light655/EENight_light_dance/inverter_v1/inverter_v1_readme.md

# Inverter_v1
This module contains the H-bridge PCB based on the DMHC-3025 chip from Diodes incorporated.
