light655/EENight_light_dance/IC.odt

- Texas Instruments 74HC595 shift register https://www.ti.com/lit/ds/symlink/sn74hc595.pdf
- Texas Instruments TPS25200 eFUSE https://www.ti.com/lit/ds/symlink/tps25200.pdf
- Analog Devices AD5160BRJZ5 digital potentiometer(RDAC) 50kΩ version https://www.analog.com/media/en/technical-documentation/data-sheets/AD5160.pdf
- Richtek RT9187QV low-dropout voltage regulator https://www.lcsc.com/datasheet/lcsc_datasheet_1811150411_Richtek-Tech-RT9187GQV_C147970.pdf
- Texas Instruments 74HC4052 analogue multiplexer https://www.ti.com/lit/ds/symlink/cd74hc4052.pdf
- Texas Instruments TLV9002 operational amplifier https://www.ti.com/lit/ds/symlink/tlv9002.pdf
