light655/EENight_light_dance/array2video/1.png

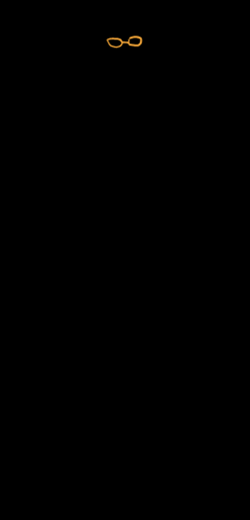
array2video/1.png
