light655/EENight_light_dance/array2video/2.png

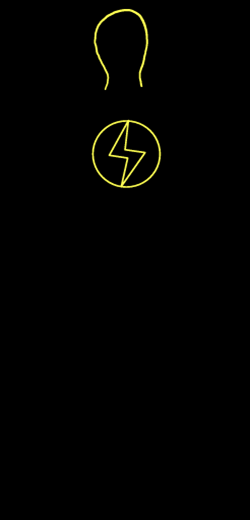
array2video/2.png
