light655/EENight_light_dance/array2video/4.png

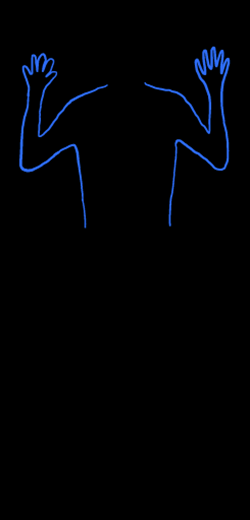
array2video/4.png
