light655/EENight_light_dance/array2video/6.png

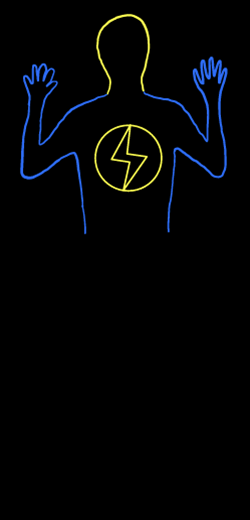
array2video/6.png
