light655/EENight_light_dance/array2video/7.png

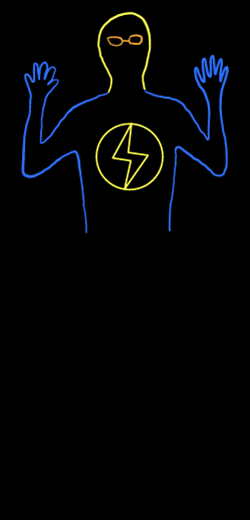
array2video/7.png
