light655/EENight_light_dance/array2video/8.png

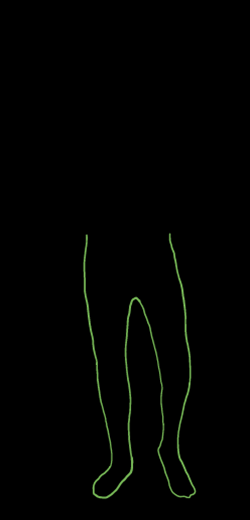
array2video/8.png
