light655/EENight_light_dance/array2video/10.png

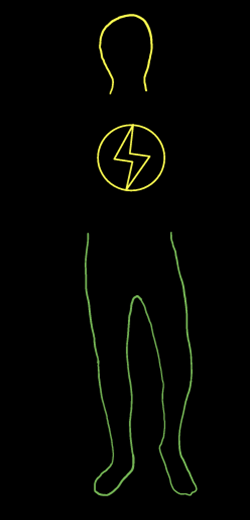
array2video/10.png
