light655/EENight_light_dance/array2video/11.png

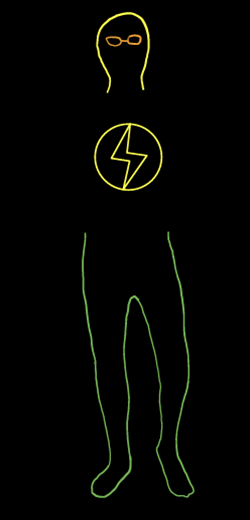
array2video/11.png
