light655/EENight_light_dance/array2video/12.png

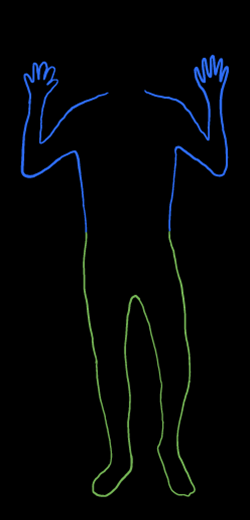
array2video/12.png
