light655/EENight_light_dance/array2video/13.png

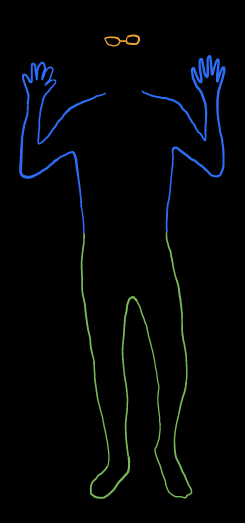
array2video/13.png
