light655/EENight_light_dance/array2video/14.png

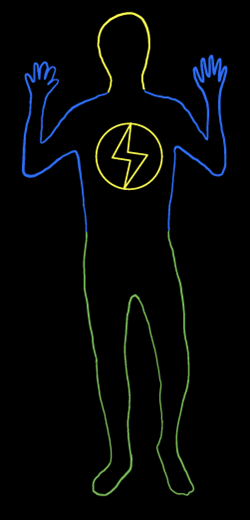
array2video/14.png
