light655/EENight_light_dance/array2video/15.png

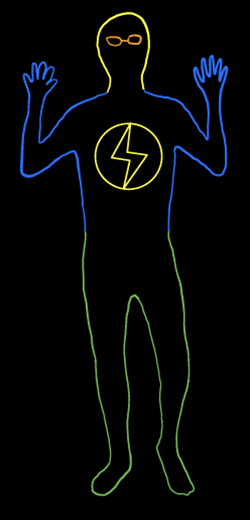
array2video/15.png
