light655/EENight_light_dance/inverter_v1/EL_oscillator/Screenshot from 2024-01-13 21-46-13.png

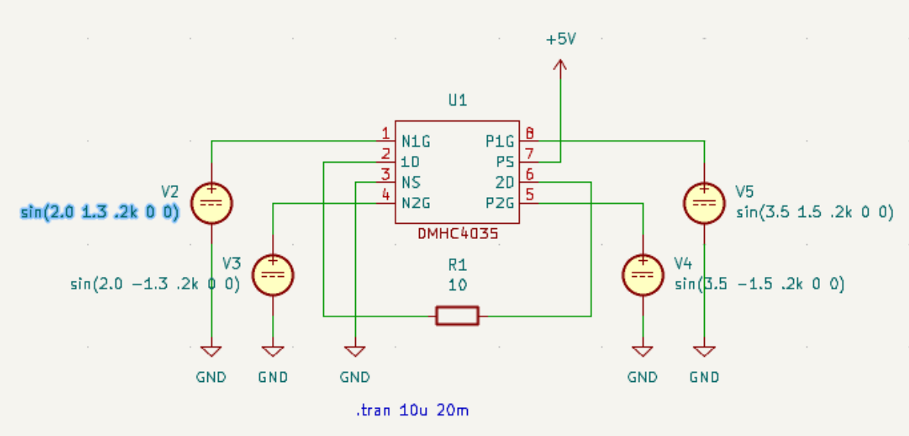
inverter_v1/EL_oscillator/Screenshot from 2024-01-13 21-46-13.png
