light655/EENight_light_dance/driver issues.odt

| Driver #
Machine # | 0 | 1 | 2 | 3
1
2
3 | Max voltage 2.1V | | Max voltage 2.6V
4
5
