light655/EENight_light_dance/pcb.pdf

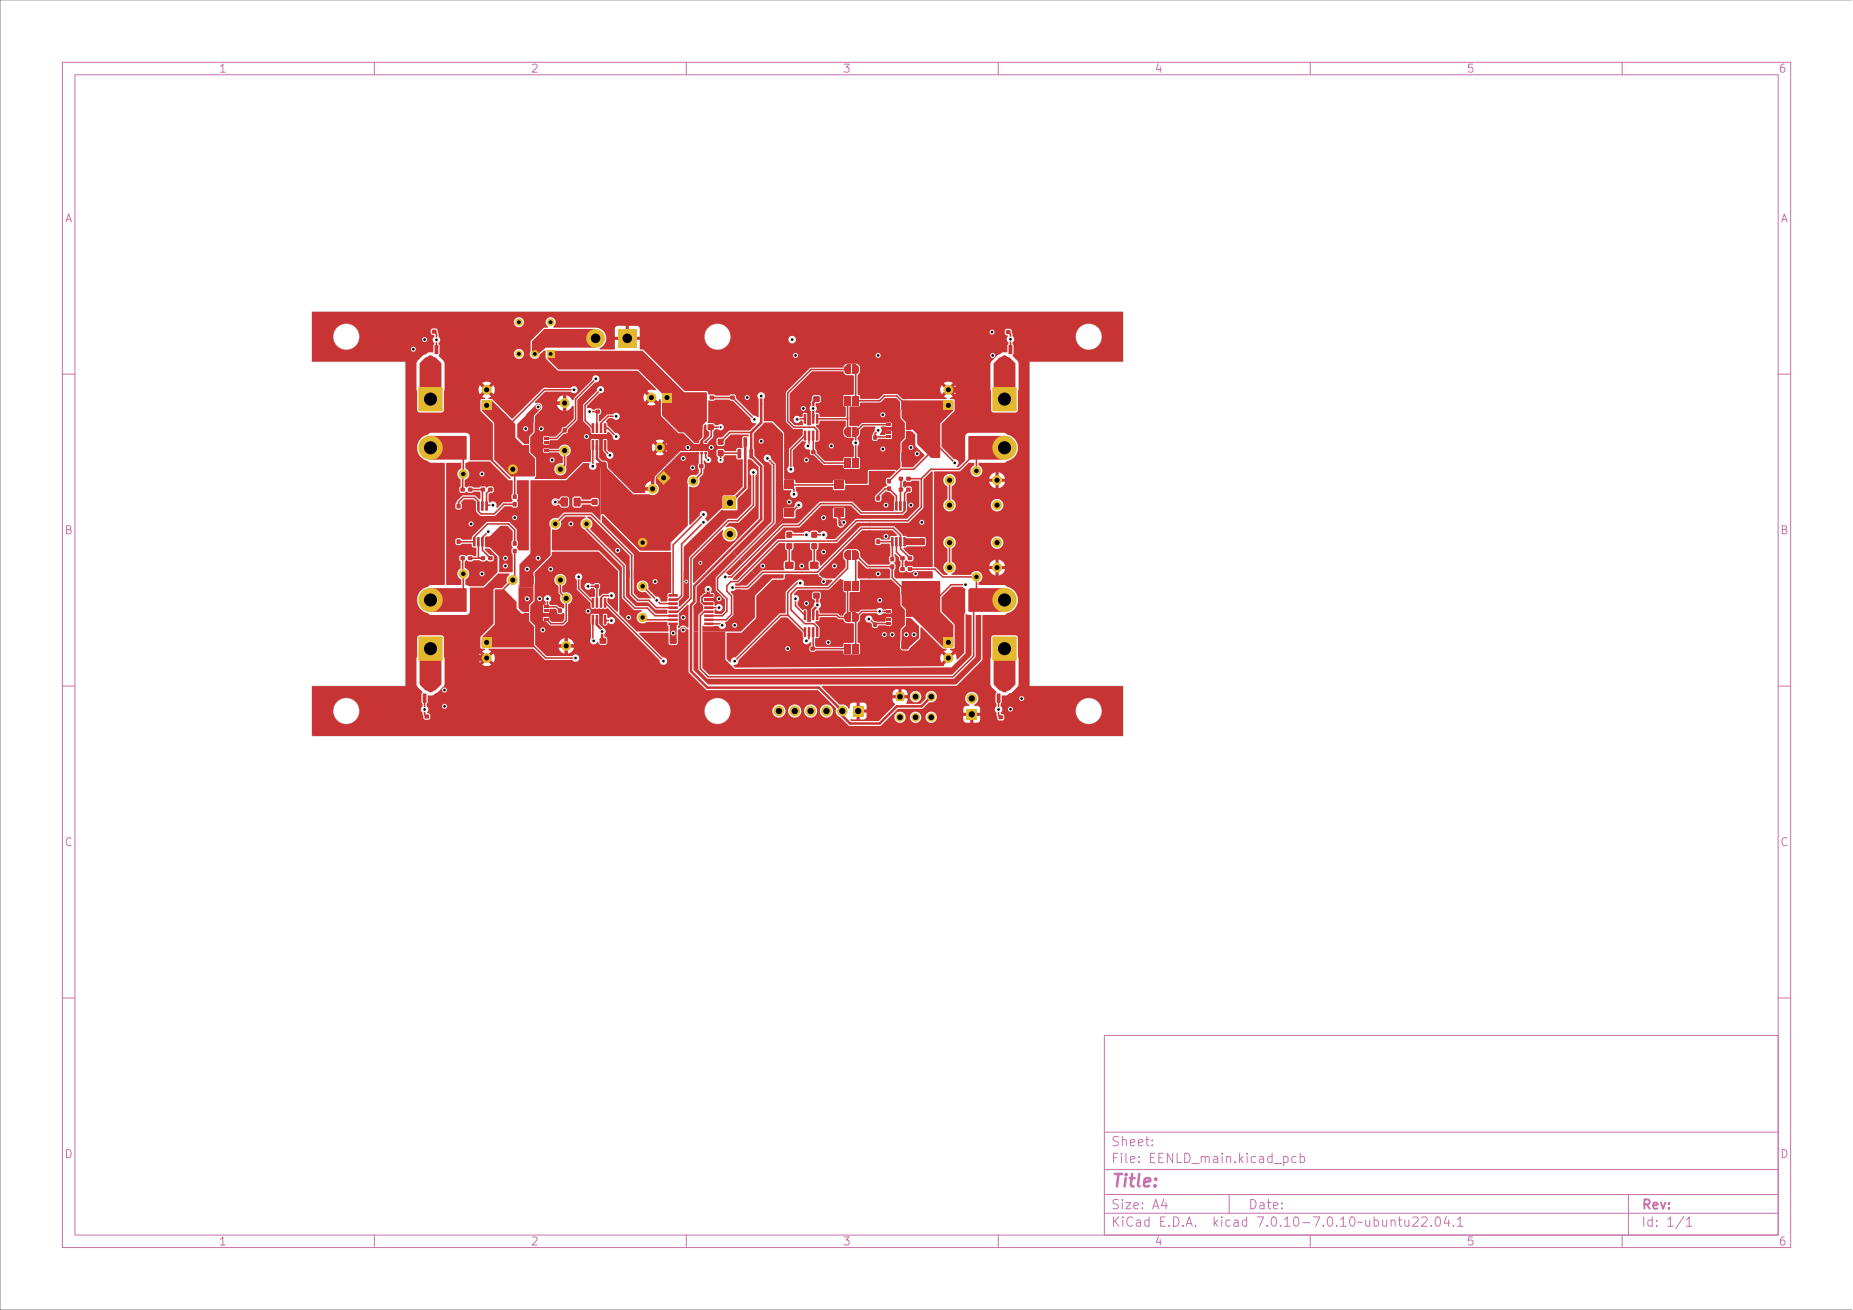
[picture p21: page 1]

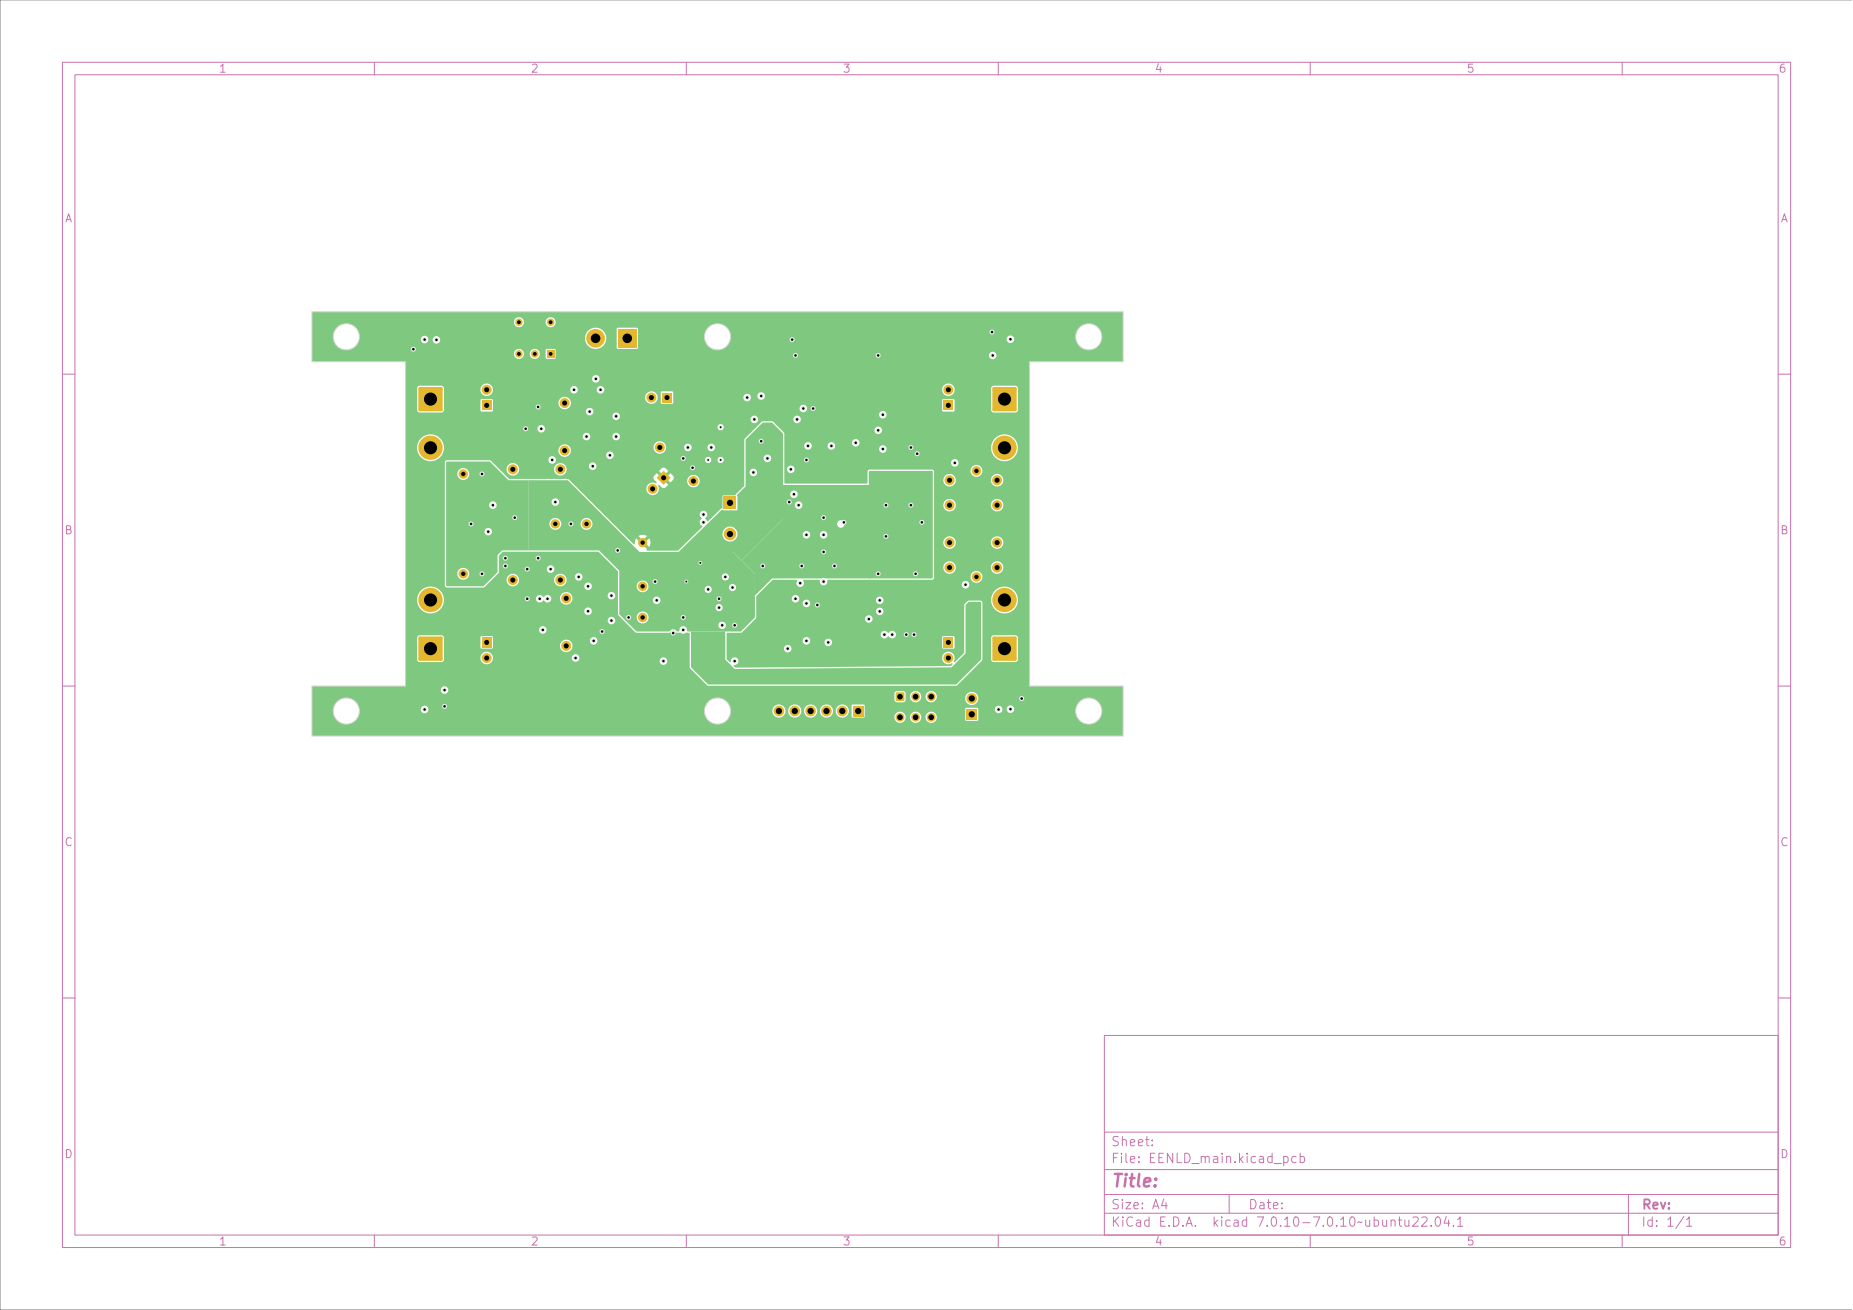
[picture p22: page 2]

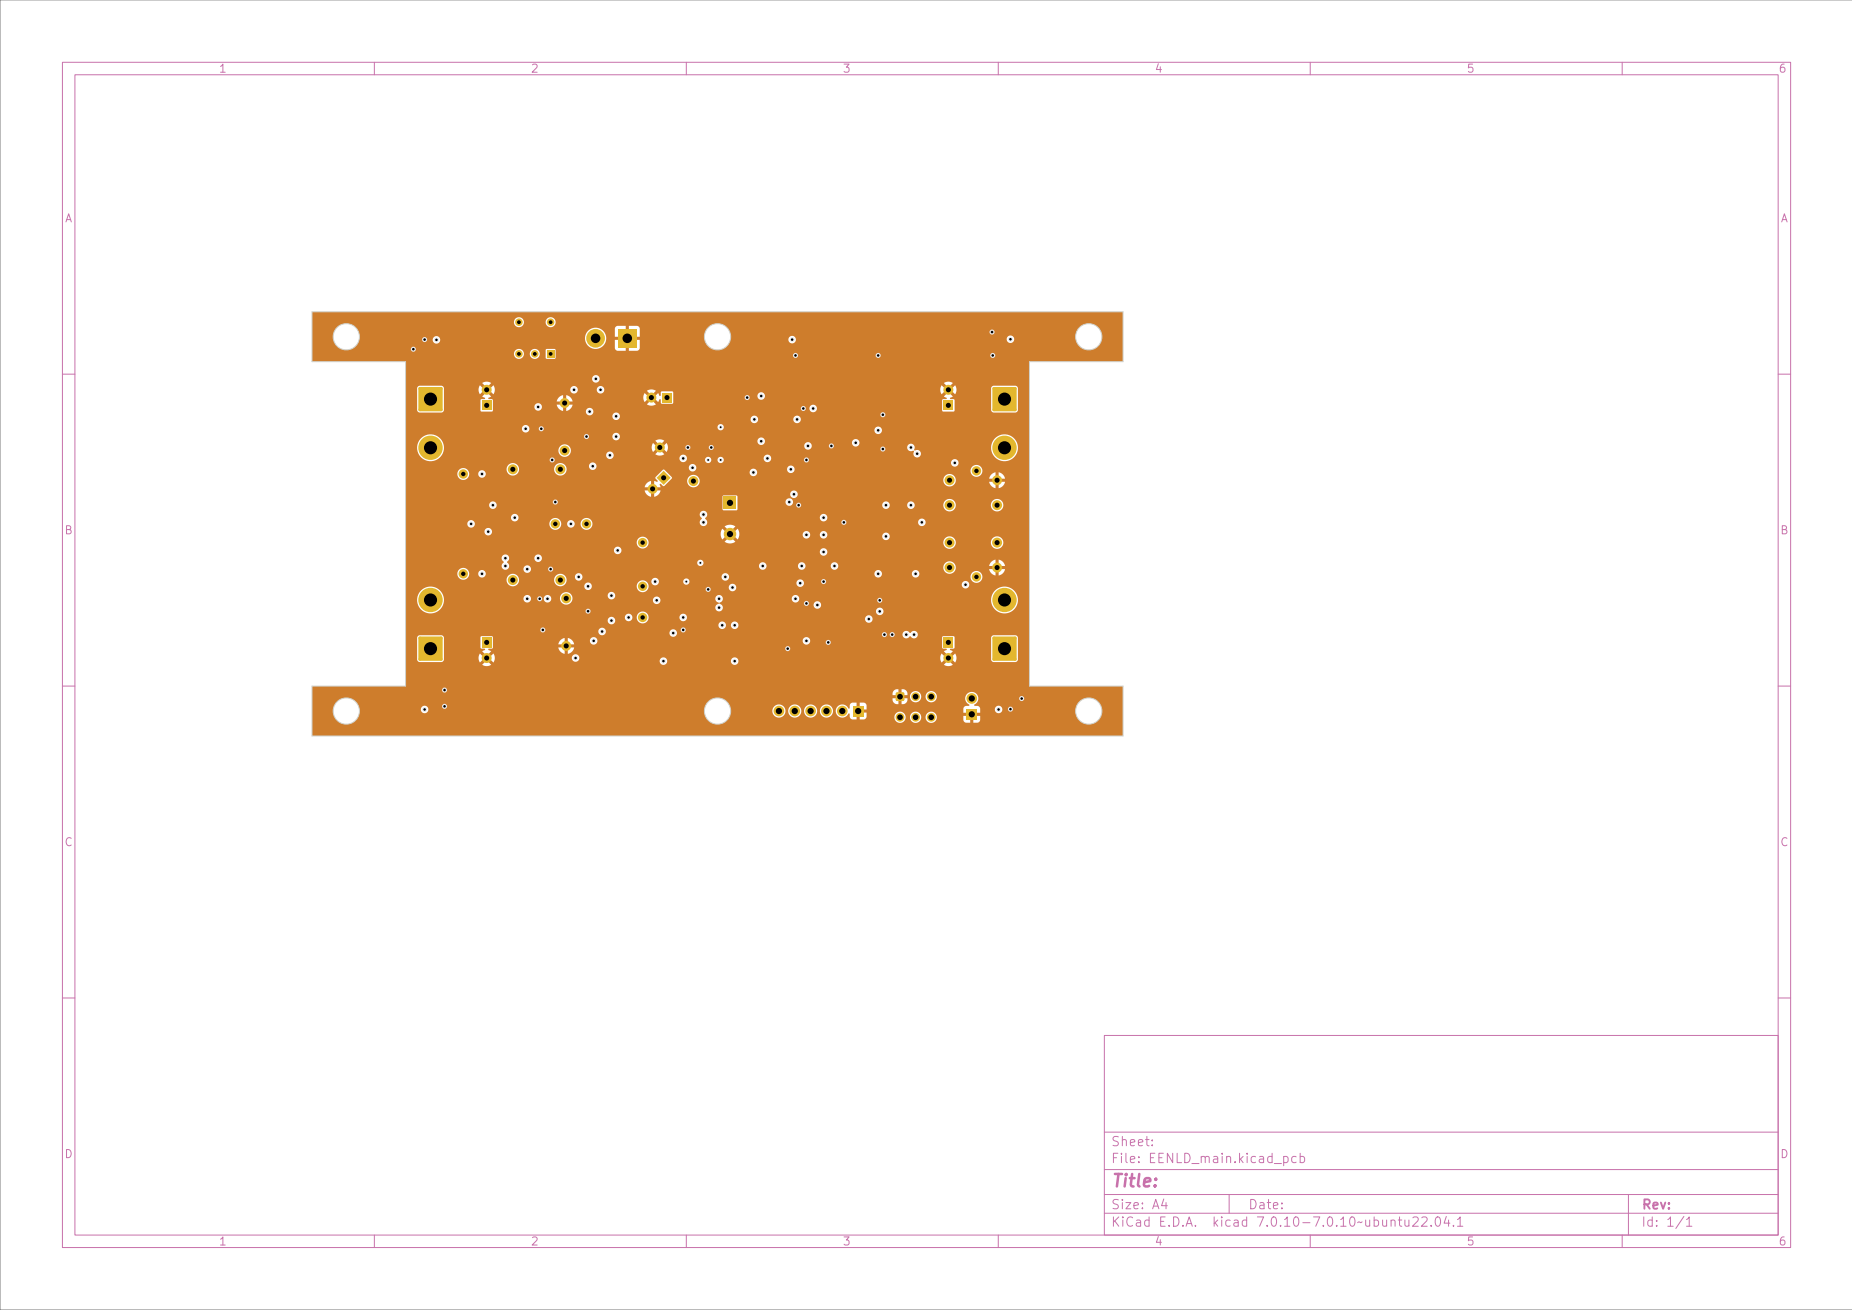
[picture p23: page 3]

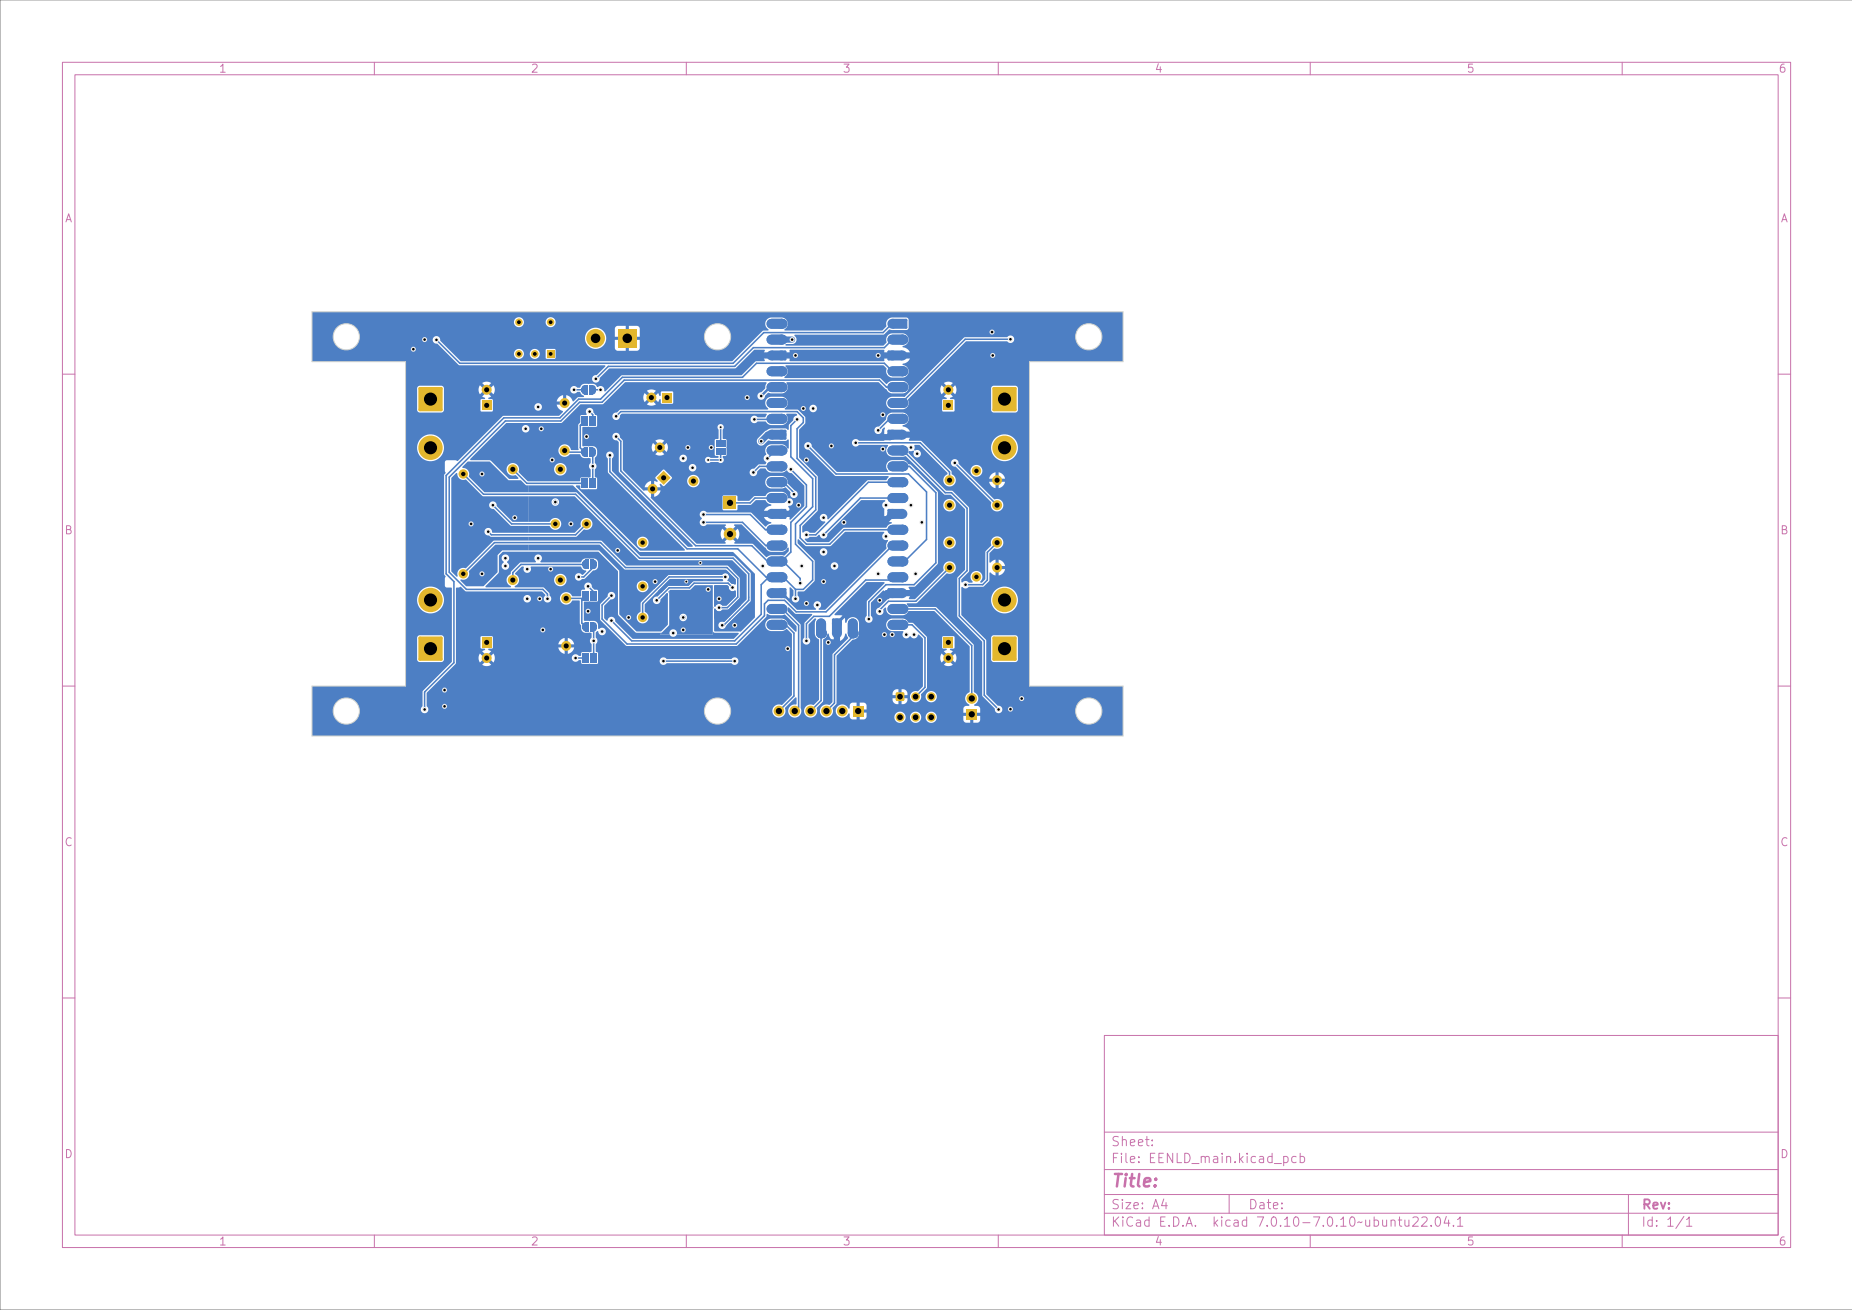
[picture p24: page 4]

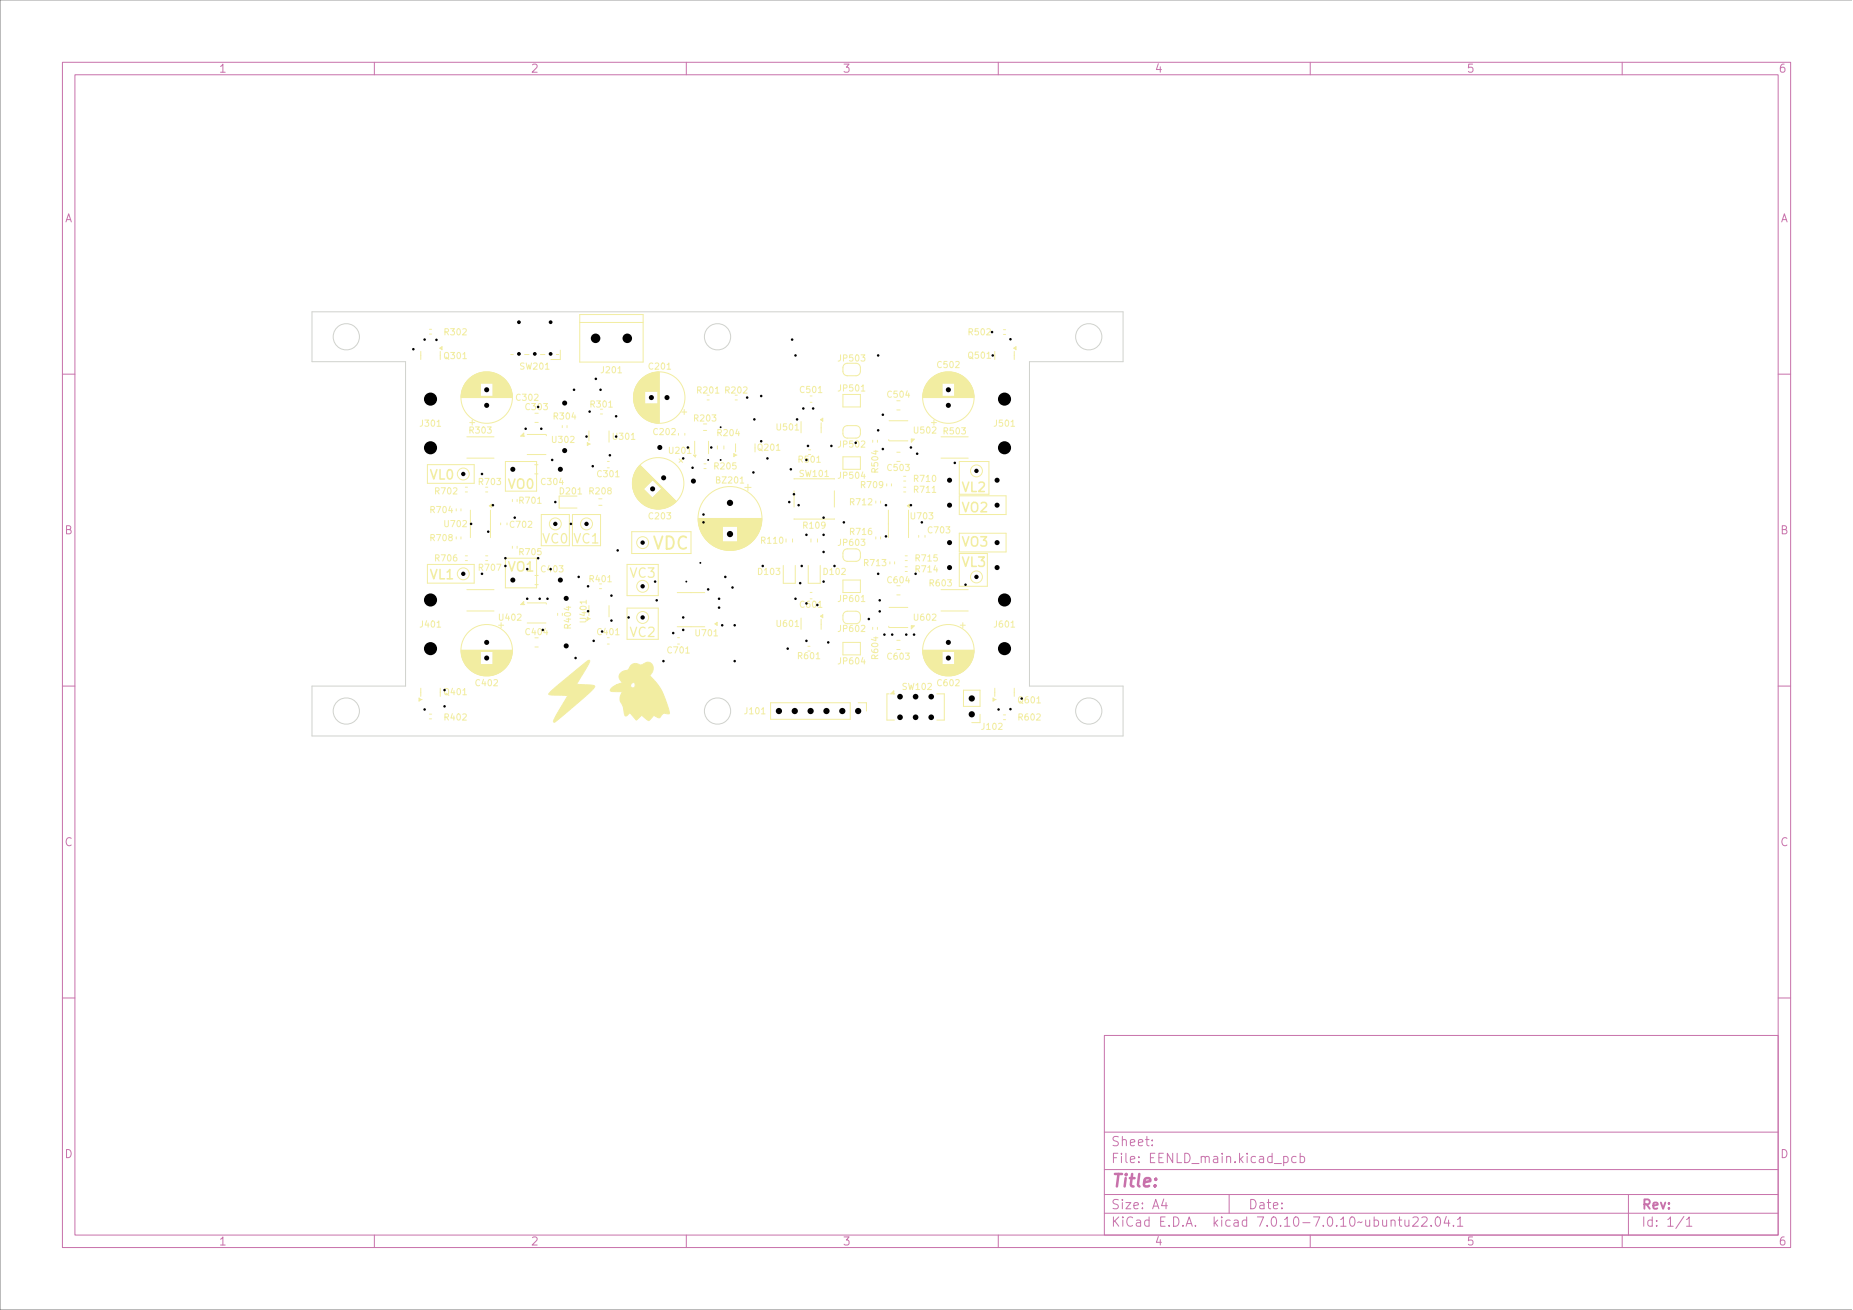
[picture p25: page 5]

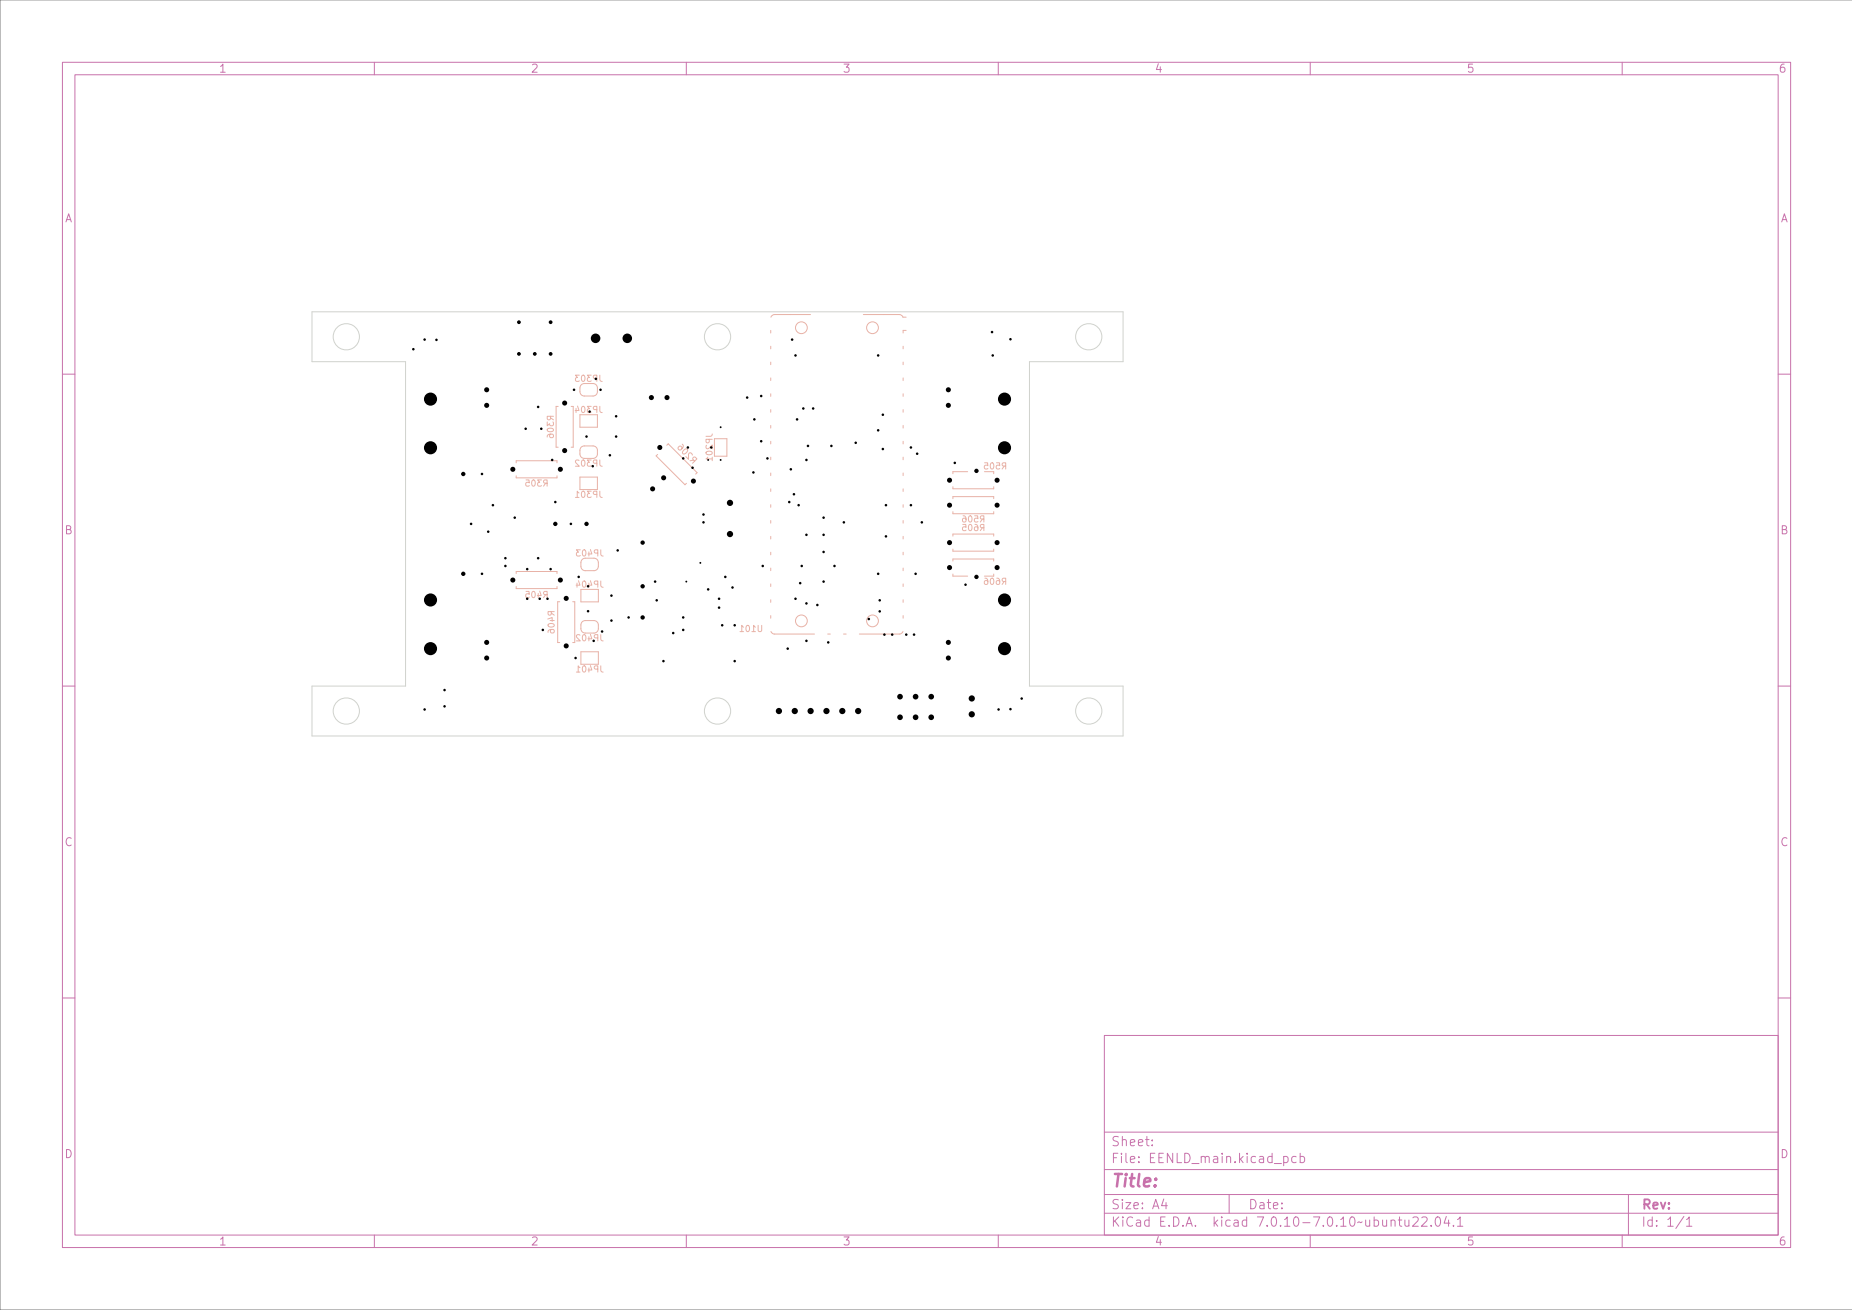
[picture p26: page 6]

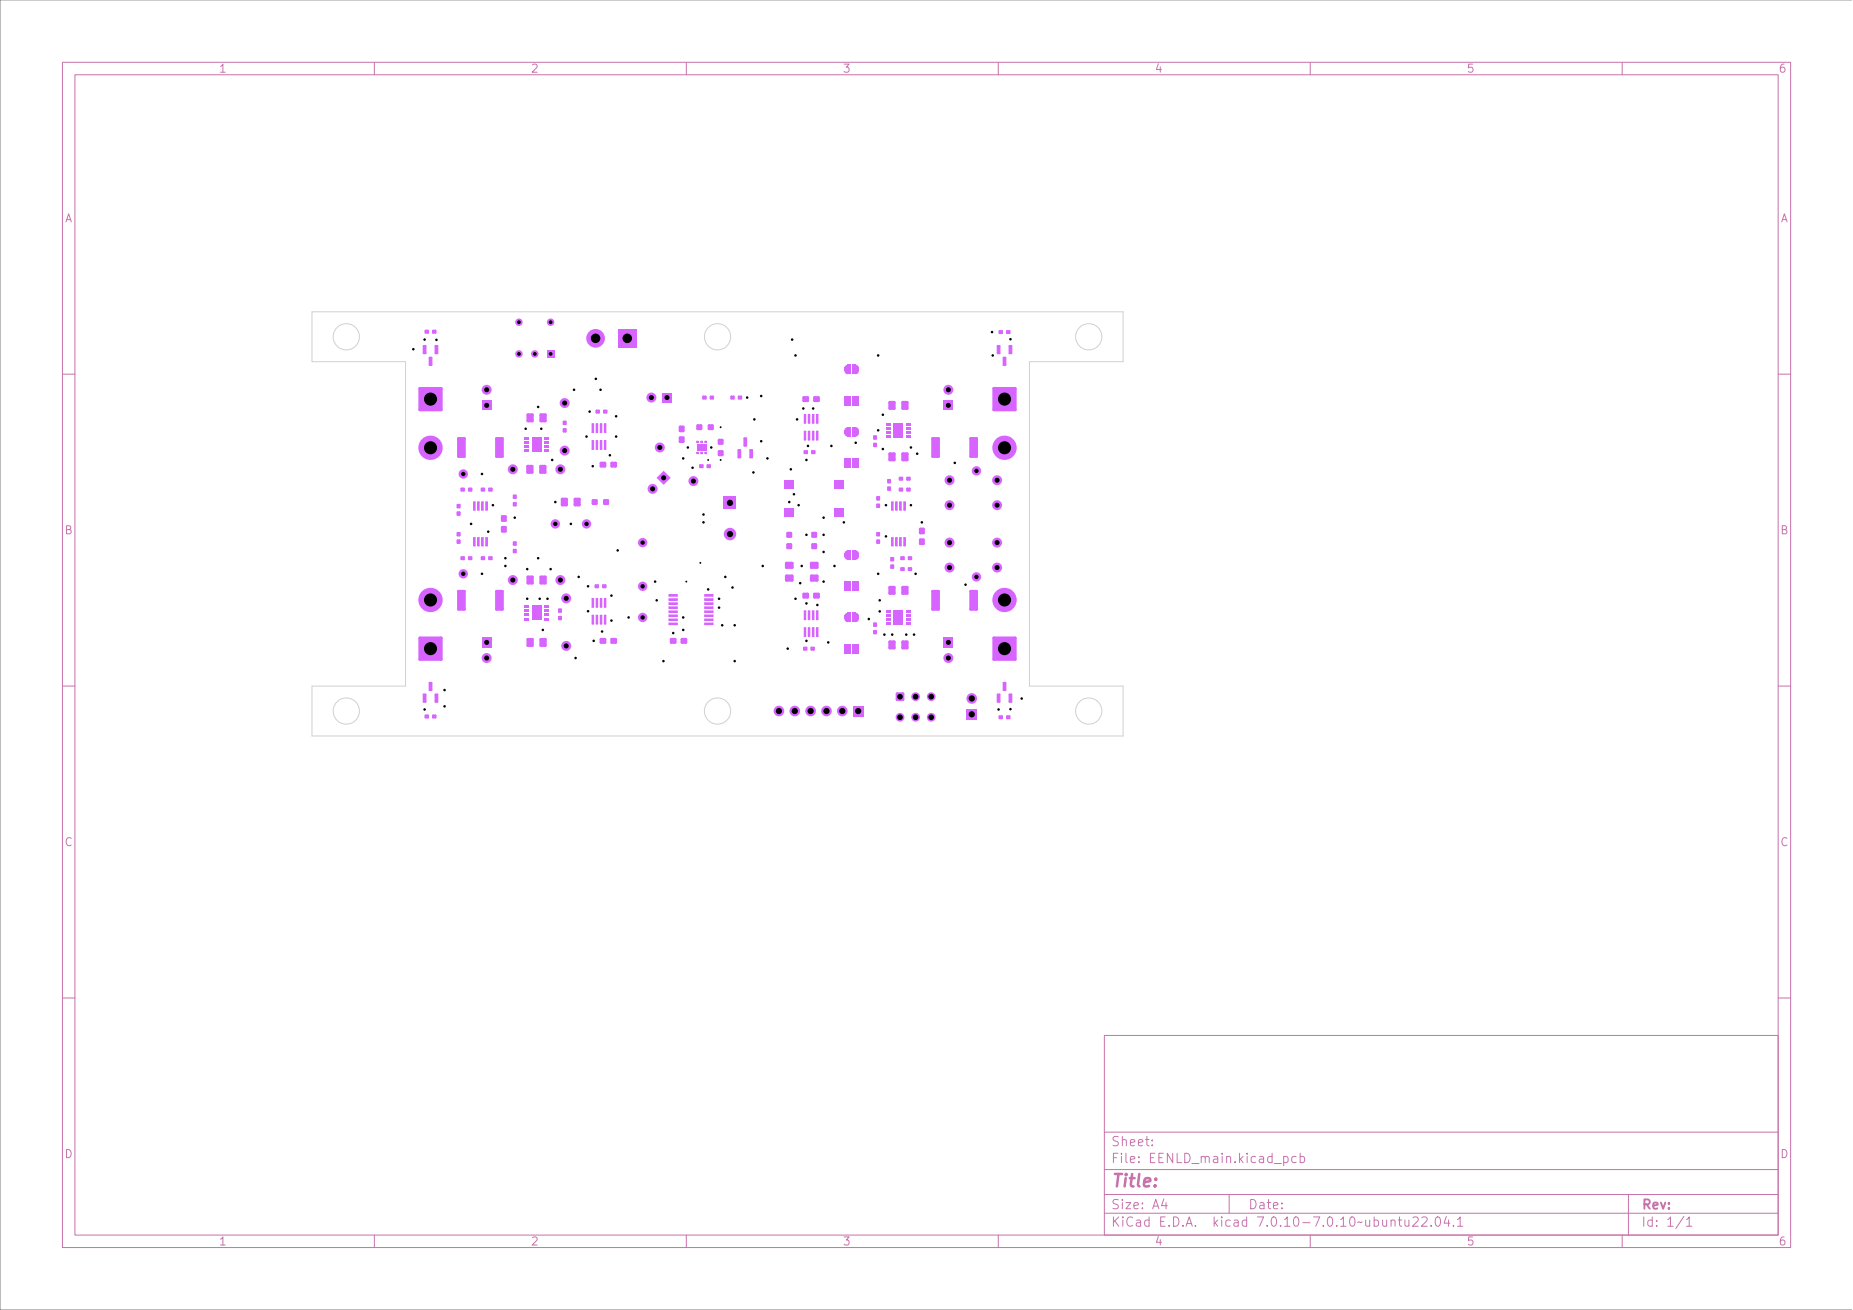
[picture p27: page 7]

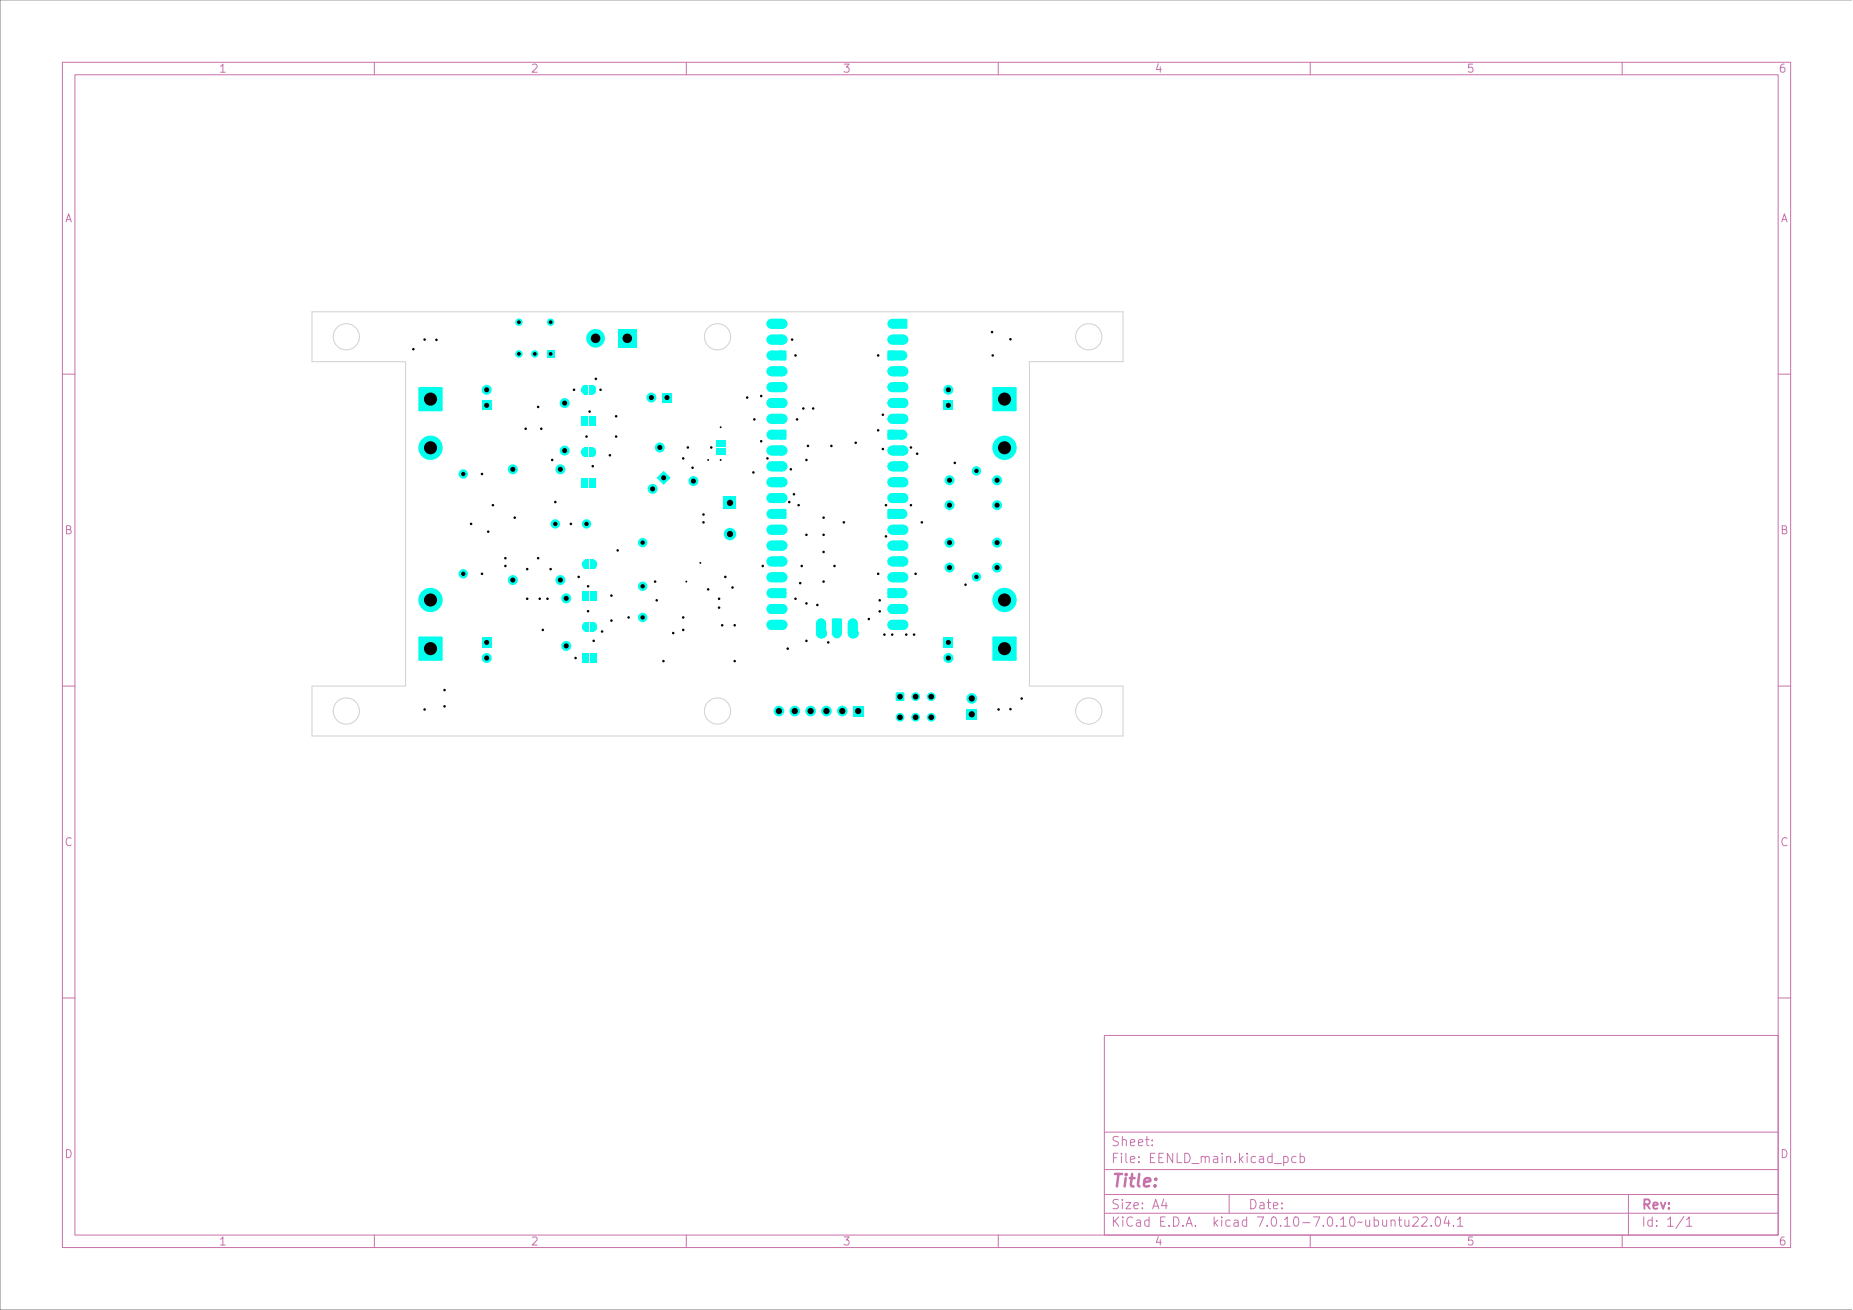
[picture p28: page 8]
