light655/EENight_light_dance/main_board/EENLD_main/EENLD_main.kicad_pcb

## KiCad design main_board/EENLD_main/EENLD_main.kicad_pcb (2024-04-01)

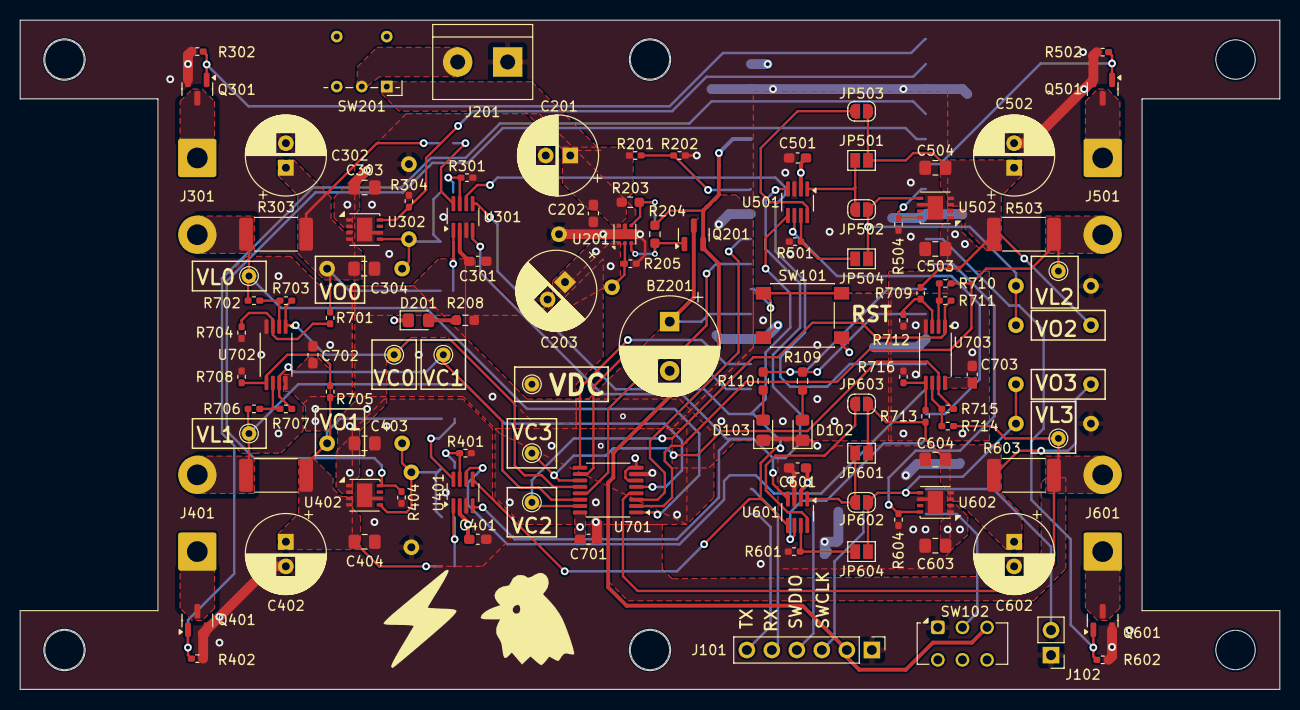
[picture p29: board EENLD_main.kicad_pcb from above]

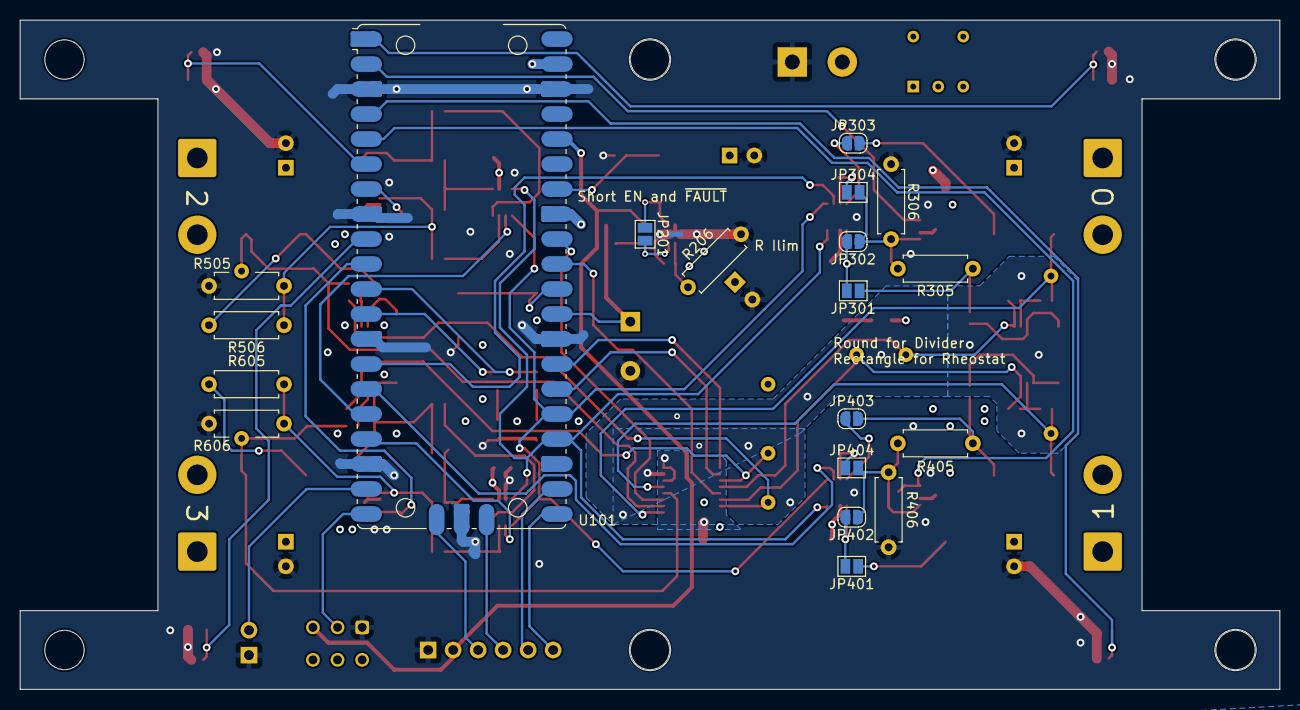
[picture p30: board EENLD_main.kicad_pcb from below]

Board: 4 copper layers, 128.0 x 68.0 mm, 129 parts (19 on the bottom side), 81 nets.

Parts:
BZ201: Buzzer; CP_Radial_D10.0mm_P5.00mm
C201, C203, C302, C402, C502, C602: 100u; CP_Radial_D8.0mm_P2.50mm
C202, C301, C401, C501, C601, C701, C702, C703: 100n; C_0603_1608Metric_Pad1.08x0.95mm_HandSolder
C303, C304, C403, C404, C503, C504, C603, C604: 2.2u; C_0805_2012Metric_Pad1.18x1.45mm_HandSolder
D102: green; LED_0805_2012Metric_Pad1.15x1.40mm_HandSolder
D103: red; LED_0805_2012Metric_Pad1.15x1.40mm_HandSolder
D201: Yellow; LED_0805_2012Metric_Pad1.15x1.40mm_HandSolder
J101: Conn_01x06_Pin; PinHeader_1x06_P2.54mm_Vertical
J102: Conn_01x02_Pin; PinHeader_1x02_P2.54mm_Vertical
J201: Conn_01x02_Socket; TerminalBlock_bornier-2_P5.08mm
J301, J401, J501, J601: Conn_01x02_Socket; SolderWire-1.5sqmm_1x02_P7.8mm_D1.7mm_OD3.9mm
JP201: SolderJumper_2_Open; SolderJumper-2_P1.3mm_Open_Pad1.0x1.5mm
JP301, JP304, JP401, JP404, JP501, JP504, JP601, JP604: Rectangle Jumper Open; SolderJumper-2_P1.3mm_Open_Pad1.0x1.5mm
JP302, JP303, JP402, JP403, JP502, JP503, JP602, JP603: Round Jumper Open; SolderJumper-2_P1.3mm_Open_RoundedPad1.0x1.5mm
Q201: AO3401A; SOT-23
Q301, Q401, Q501, Q601: AO3400A; SOT-23
R109, R110, R208: 1k; R_0603_1608Metric_Pad0.98x0.95mm_HandSolder
R201, R202, R205: 47k; R_0402_1005Metric_Pad0.72x0.64mm_HandSolder
R203, R204: 300k; R_0603_1608Metric_Pad0.98x0.95mm_HandSolder
R206: 47k; R_Axial_DIN0207_L6.3mm_D2.5mm_P7.62mm_Horizontal
R301, R401, R501, R601: 12k; R_0402_1005Metric_Pad0.72x0.64mm_HandSolder
R302, R304, R402, R404, R502, R504, R602, R604, R701, R702, R705, R706, R709, R710, R713, R714: 10k; R_0402_1005Metric_Pad0.72x0.64mm_HandSolder
R303, R403, R503, R603: 200m; R_2512_6332Metric_Pad1.40x3.35mm_HandSolder
R305, R306, R405, R406, R505, R506, R605, R606: 27k; R_Axial_DIN0207_L6.3mm_D2.5mm_P7.62mm_Horizontal
R703, R704, R707, R708, R711, R712, R715, R716: 200k; R_0402_1005Metric_Pad0.72x0.64mm_HandSolder
SW101: SW_Push; SW_Push_1P1T_NO_6x6mm_H9.5mm
SW102: SW_SPDT; SW_CK_JS202011CQN_DPDT_Straight
SW201: SW_SPDT; SW_Lever_1P2T_NKK_GW12LxH
TP201, TP302, TP402, TP502, TP602, TP701, TP702, TP703, TP704: TestPoint; TestPoint_THTPad_D1.5mm_Drill0.7mm
U101: Pico; RaspberryPi_Pico_Original_SMD
U201: TPS25200DRVR; WSON-6-1EP_2x2mm_P0.65mm_EP1x1.6mm_ThermalVias
U301, U401, U501, U601: AD5160BRJZ5; SOT-23-8_Handsoldering
U302, U402, U502, U602: RT9187QV; DFN-8-1EP_3x3mm_P0.65mm_EP1.55x2.4mm
U701: 74HC4052; TSSOP-16_4.4x5mm_P0.65mm
U702, U703: TLV9002; TSSOP-8_4.4x3mm_P0.65mm

Connections:
+3V3: J101.2, Q201.2 (S), R204.1, SW102.3 (C), U101.36 (3V3)
+BATT: C201.1, C202.1, R201.1, R203.1, SW201.1 (A), U201.6 (IN)
/ANALOG_A: U101.31 (GPIO26_ADC0), U701.13 (AN)
/ANALOG_B: U101.32 (GPIO27_ADC1), U701.3 (BN)
/Analogue signal processing/VC0: R703.1, TP701.1, U701.12 (A0), U702.1
/Analogue signal processing/VC1: R707.1, TP702.1, U701.14 (A1), U702.7
/Analogue signal processing/VC2: R711.1, TP703.1, U701.15 (A2), U703.1
/Analogue signal processing/VC3: R715.1, TP704.1, U701.11 (A3), U703.7
/Battery & protection/eFUSE_EN: JP201.1 (A), R203.2, U201.4 (EN)
/Battery & protection/eFUSE_~FAULT: JP201.2 (B), Q201.1 (G), R204.2, U201.3 (*FAULT)
/EL driver 0/LDO_feedback: JP302.1 (A), JP304.2 (B), R305.2, R306.1, U302.5 (ADJ)
/EL driver 1/LDO_feedback: JP402.1 (A), JP404.2 (B), R405.2, R406.1, U402.5 (ADJ)
/EL driver 2/LDO_feedback: JP502.1 (A), JP504.2 (B), R505.2, R506.1, U502.5 (ADJ)
/EL driver 3/LDO_feedback: JP602.1 (A), JP604.2 (B), R605.2, R606.1, U602.5 (ADJ)
/LDO_EN0: R304.1, U101.2 (GPIO1), U302.8 (EN)
/LDO_EN1: R404.1, U101.5 (GPIO3), U402.8 (EN)
/LDO_EN2: R504.1, U101.7 (GPIO5), U502.8 (EN)
/LDO_EN3: R604.1, U101.10 (GPIO7), U602.8 (EN)
/MUX_S0: U101.26 (GPIO20), U701.10 (S0)
/MUX_S1: U101.27 (GPIO21), U701.9 (S1)
/PWM0: Q301.1 (G), R302.1, U101.1 (GPIO0)
/PWM1: Q401.1 (G), R402.1, U101.4 (GPIO2)
/PWM2: Q501.1 (G), R502.1, U101.6 (GPIO4)
/PWM3: Q601.1 (G), R602.1, U101.9 (GPIO6)
/SPI_CLK: U101.24 (GPIO18), U301.4 (CLK), U401.4 (CLK), U501.4 (CLK), U601.4 (CLK)
/SPI_TX: U101.25 (GPIO19), U301.5 (SDI), U401.5 (SDI), U501.5 (SDI), U601.5 (SDI)
/SPI_~CS0: U101.14 (GPIO10), U301.6 (~CS)
/SPI_~CS1: U101.15 (GPIO11), U401.6 (~CS)
/SPI_~CS2: U101.16 (GPIO12), U501.6 (~CS)
/SPI_~CS3: U101.17 (GPIO13), U601.6 (~CS)
/SSD_CLK: R110.1, U101.11 (GPIO8)
/SSD_DATA: R109.1, U101.12 (GPIO9)
/SWCLK: J101.3, U101.41 (SWCLK)
/SWDIO: J101.4, U101.43 (SWDIO)
/T_SYNC: J102.2, U101.19 (GPIO14)
/UART0_RX: J101.5, U101.22 (GPIO17)
/UART0_TX: J101.6, U101.21 (GPIO16)
/VBAT_sense: R201.2, R202.1, U101.34 (GPIO28_ADC2)
/VL0: J301.2, R303.2, R702.1, TP302.1, U701.1 (B0)
/VL1: J401.2, R403.2, R706.1, TP402.1, U701.5 (B1)
/VL2: J501.2, R503.2, R710.1, TP502.1, U701.2 (B2)
/VL3: J601.2, R603.2, R714.1, TP602.1, U701.4 (B3)
/VO0: C302.1, C304.1, JP301.1 (A), JP303.2 (B), R303.1, R305.1, R701.1, U302.3 (VOUT), U302.4 (VOUT)
/VO1: C402.1, C404.1, JP401.1 (A), JP403.2 (B), R403.1, R405.1, R705.1, U402.3 (VOUT), U402.4 (VOUT)
/VO2: C502.1, C504.1, JP501.1 (A), JP503.2 (B), R503.1, R505.1, R709.1, U502.3 (VOUT), U502.4 (VOUT)
/VO3: C602.1, C604.1, JP601.1 (A), JP603.2 (B), R603.1, R605.1, R713.1, U602.3 (VOUT), U602.4 (VOUT)
/eFUSE_FAULT: BZ201.1 (+), Q201.3 (D), U101.29 (GPIO22)
GND: BZ201.2 (-), C201.2, C202.2, C203.2, C301.2, C302.2, C303.2, C304.2, C401.2, C402.2, C403.2, C404.2, C501.2, C502.2, C503.2, C504.2, C601.2, C602.2, C603.2, C604.2, C701.2, D102.1 (K), D103.1 (K), D201.1 (K), J101.1, J102.1, J201.1, Q301.2 (S), Q401.2 (S), Q501.2 (S), Q601.2 (S), R202.2, R205.2, R206.2, R301.2, R302.2, R304.2, R306.2, R401.2, R402.2, R404.2, R406.2, R501.2, R502.2, R504.2, R506.2, R601.2, R602.2, R604.2, R606.2, SW101.2, SW102.1 (A), U101.3 (GND), U101.8 (GND), U101.13 (GND), U101.18 (GND), U101.23 (GND), U101.28 (GND), U101.38 (GND), U101.42 (GND), U201.5 (GND), U201.7 (EPAD), U301.3 (GND), U302.6 (GND), U302.9 (GND), U401.3 (GND), U402.6 (GND), U402.9 (GND), U501.3 (GND), U502.6 (GND), U502.9 (GND), U601.3 (GND), U602.6 (GND), U602.9 (GND), U701.6 (~E), U701.8 (GND)
GNDA: C702.2, C703.2, R704.2, R708.2, R712.2, R716.2, U101.33 (AGND), U701.7 (VEE), U702.4 (V-), U703.4 (V-)
unnamed: D102.2 (A), R109.2
unnamed: D103.2 (A), R110.2
unnamed: D201.2 (A), R208.2
unnamed: J201.2, SW201.2 (B)
unnamed: J301.1, Q301.3 (D)
unnamed: J401.1, Q401.3 (D)
unnamed: J501.1, Q501.3 (D)
unnamed: J601.1, Q601.3 (D)
unnamed: JP301.2 (B), JP302.2 (B), U301.1 (W)
unnamed: JP303.1 (A), U301.8 (A)
unnamed: JP304.1 (A), R301.1, U301.7 (B)
unnamed: JP401.2 (B), JP402.2 (B), U401.1 (W)
unnamed: JP403.1 (A), U401.8 (A)
unnamed: JP404.1 (A), R401.1, U401.7 (B)
unnamed: JP501.2 (B), JP502.2 (B), U501.1 (W)
unnamed: JP503.1 (A), U501.8 (A)
unnamed: JP504.1 (A), R501.1, U501.7 (B)
unnamed: JP601.2 (B), JP602.2 (B), U601.1 (W)
unnamed: JP603.1 (A), U601.8 (A)
unnamed: JP604.1 (A), R601.1, U601.7 (B)
unnamed: SW102.2 (B), U101.20 (GPIO15)
unnamed: SW101.1, U101.30 (RUN)
unnamed: R205.1, R206.1, U201.2 (ILIM)
unnamed: R701.2, R704.1, U702.3 (+)
unnamed: R702.2, R703.2, U702.2 (-)
unnamed: R705.2, R708.1, U702.5 (+)
unnamed: R706.2, R707.2, U702.6 (-)
unnamed: R709.2, R712.1, U703.3 (+)
unnamed: R710.2, R711.2, U703.2 (-)
unnamed: R713.2, R716.1, U703.5 (+)
unnamed: R714.2, R715.2, U703.6 (-)
VDC: C203.1, C301.1, C303.1, C401.1, C403.1, C501.1, C503.1, C601.1, C603.1, C701.1, C702.1, C703.1, R208.1, TP201.1, U101.39 (VSYS), U201.1 (OUT), U301.2 (VDD), U302.1 (VIN), U302.2 (VIN), U401.2 (VDD), U402.1 (VIN), U402.2 (VIN), U501.2 (VDD), U502.1 (VIN), U502.2 (VIN), U601.2 (VDD), U602.1 (VIN), U602.2 (VIN), U701.16 (VDD), U702.8 (V+), U703.8 (V+)
