light655/EENight_light_dance/BMS/BMS_hardware/BMS_hardware.kicad_pcb

## KiCad design BMS/BMS_hardware/BMS_hardware.kicad_pcb (2024-03-17)

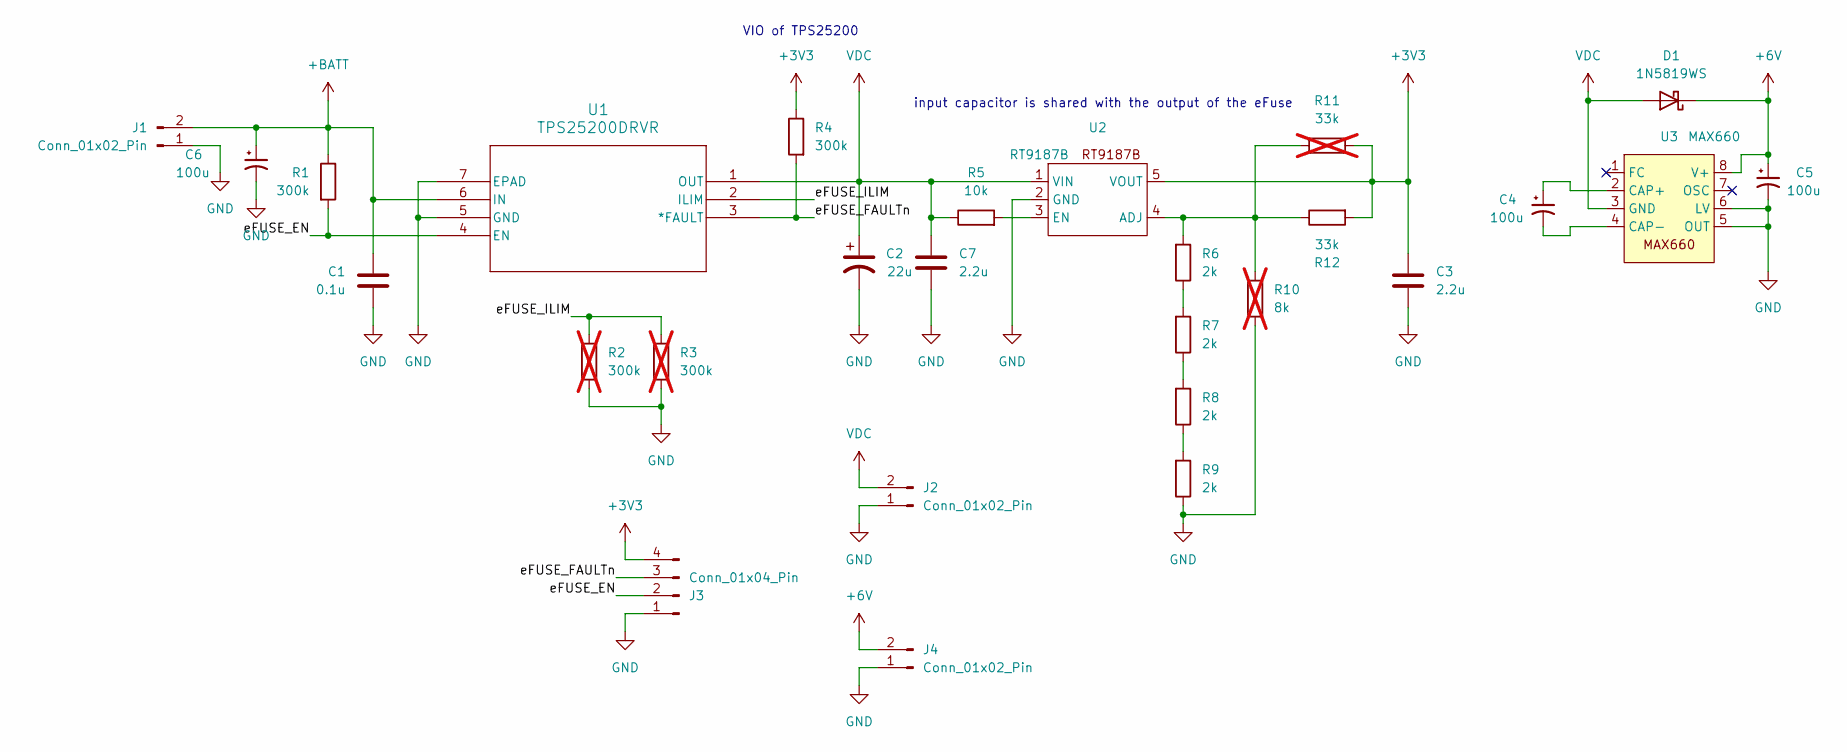
[picture p31: schematic BMS_hardware.kicad_sch]

Parts:
C1: 0.1u; C_0603_1608Metric_Pad1.08x0.95mm_HandSolder; LCSC C14663
C2: 22u; CP_Radial_D6.3mm_P2.50mm
C3, C7: 2.2u; C_0805_2012Metric_Pad1.18x1.45mm_HandSolder; LCSC C377773
C4, C5, C6: 100u; CP_Radial_D6.3mm_P2.50mm
D1: 1N5819WS; D_SOD-323; LCSC C191023
J1, J2, J4: Conn_01x02_Pin; TerminalBlock_Phoenix_MKDS-1,5-2-5.08_1x02_P5.08mm_Horizont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
J3: Conn_01x04_Pin; PinHeader_1x04_P2.54mm_Vertical
R1, R4: 300k; R_0603_1608Metric_Pad0.98x0.95mm_HandSolder; LCSC C23024
R2, R3: 300k; R_Axial_DIN0207_L6.3mm_D2.5mm_P7.62mm_Horizontal; not fitted
R5: 10k; R_0603_1608Metric_Pad0.98x0.95mm_HandSolder; LCSC C25804
R6, R7, R8, R9: 2k; R_0603_1608Metric_Pad0.98x0.95mm_HandSolder; LCSC C22975
R10: 8k; R_Axial_DIN0207_L6.3mm_D2.5mm_P7.62mm_Horizontal; not fitted
R11: 33k; R_Axial_DIN0207_L6.3mm_D2.5mm_P7.62mm_Horizontal; not fitted
R12: 33k; R_0603_1608Metric_Pad0.98x0.95mm_HandSolder; LCSC C4216
U1: TPS25200DRVR; WSON-6-1EP_2x2mm_P0.65mm_EP1x1.6mm_ThermalVias; LCSC C128401
U2: RT9187B; SOT-23-5_HandSoldering; LCSC C3031681
U3: MAX660; SOIC-8_3.9x4.9mm_P1.27mm

Connections:
+3V3: C3.1, J3.4, R4.1, R11.2, R12.2, U2.5 (VOUT)
+6V: C5.1, D1.1 (K), J4.2, U3.8 (V+)
+BATT: C1.1, C6.1, J1.2, R1.1, U1.6 (IN)
/eFUSE_EN: J3.2, R1.2, U1.4 (EN)
/eFUSE_FAULTn: J3.3, R4.2, U1.3 (*FAULT)
/eFUSE_ILIM: R2.1, R3.1, U1.2 (ILIM)
GND: C1.2, C2.2, C3.2, C5.2, C6.2, C7.2, J1.1, J2.1, J3.1, J4.1, R2.2, R3.2, R9.1, R10.2, U1.5 (GND), U1.7 (EPAD), U2.2 (GND), U3.5 (OUT), U3.6 (LV)
unnamed: R6.1, R7.2
unnamed: R7.1, R8.2
unnamed: R8.1, R9.2
unnamed: R6.2, R10.1, R11.1, R12.1, U2.4 (ADJ)
unnamed: R5.2, U2.3 (EN)
unnamed: C4.1, U3.2 (CAP+)
unnamed: C4.2, U3.4 (CAP-)
VDC: C2.1, C7.1, D1.2 (A), J2.2, R5.1, U1.1 (OUT), U2.1 (VIN), U3.3 (GND)

Notes on the sheet:
VIO of TPS25200
input capacitor is shared with the output of the eFuse

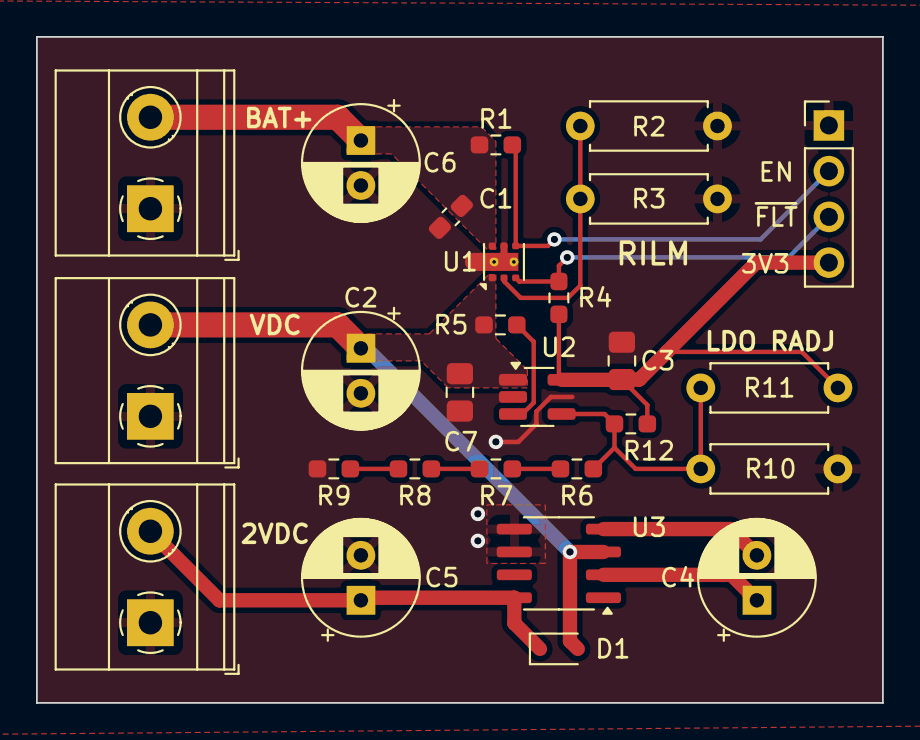
[picture p32: board BMS_hardware.kicad_pcb from above]

Board: 2 copper layers, 47.0 x 37.0 mm, 27 parts (0 on the bottom side), 15 nets.
