light655/EENight_light_dance/tps25200_v1/test.kicad_pcb

## KiCad design tps25200_v1/test.kicad_pcb (2024-02-23)

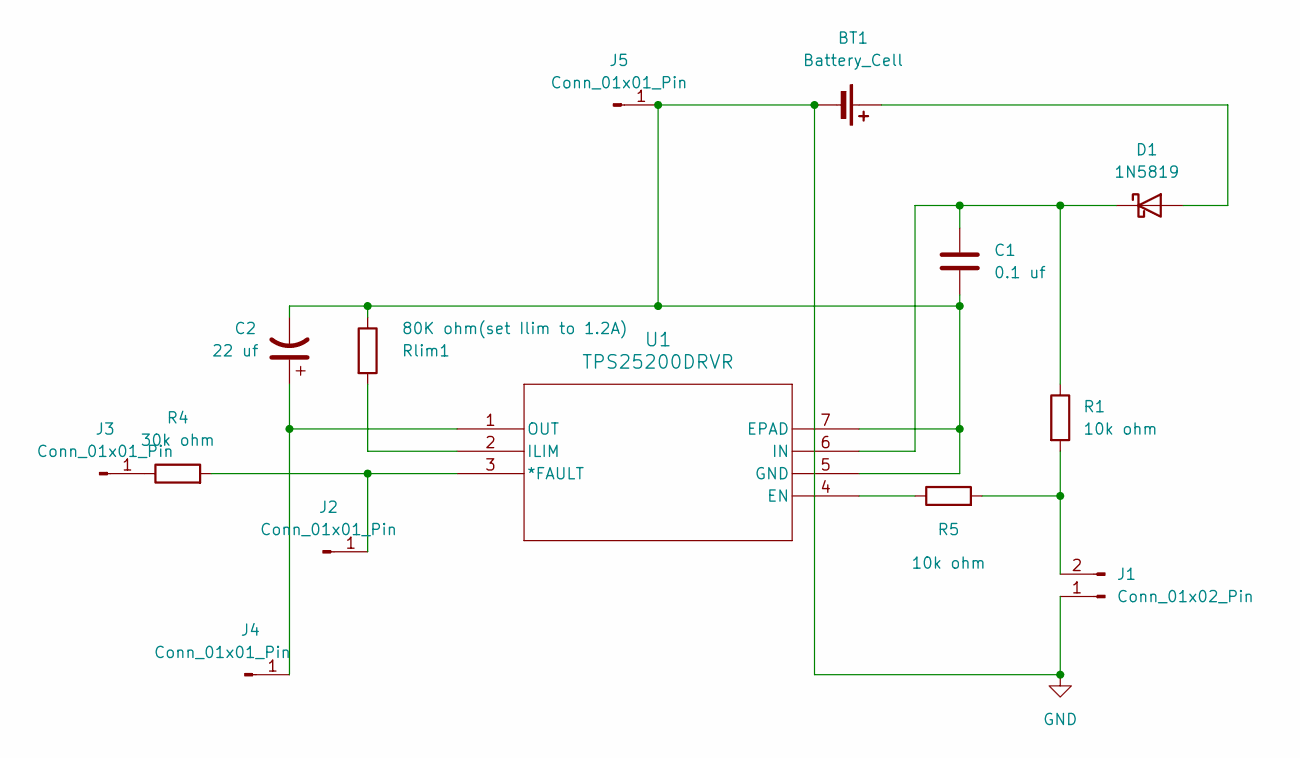
[picture p33: schematic test.kicad_sch]

Parts:
BT1: Battery_Cell; BatteryHolder_MPD_BH-18650-PC2
C1: 0.1 uf; C_0603_1608Metric_Pad1.08x0.95mm_HandSolder
C2: 22 uf; CP_Radial_D8.0mm_P2.50mm
D1: 1N5819; D_DO-41_SOD81_P10.16mm_Horizontal
J1: Conn_01x02_Pin; PinHeader_1x02_P2.54mm_Vertical
J2, J3, J4, J5: Conn_01x01_Pin; PinHeader_1x01_P2.54mm_Vertical
R1, R5: 10k ohm; R_0603_1608Metric_Pad0.98x0.95mm_HandSolder
R4: 30k ohm; R_0603_1608Metric_Pad0.98x0.95mm_HandSolder
Rlim1: 80K ohm(set Ilim to 1.2A); R_0603_1608Metric_Pad0.98x0.95mm_HandSolder
U1: TPS25200DRVR; DRV6_1X1P6_TEX

Connections:
GND: BT1.2 (-), C1.2, C2.2, J1.1, J5.1, Rlim1.1, U1.5 (GND), U1.7 (EPAD)
unnamed: BT1.1 (+), D1.2 (A)
unnamed: C1.1, D1.1 (K), R1.1, U1.6 (IN)
unnamed: J1.2, R1.2, R5.2
unnamed: J2.1, R4.2, U1.3 (*FAULT)
unnamed: J3.1, R4.1
unnamed: C2.1, J4.1, U1.1 (OUT)
unnamed: R5.1, U1.4 (EN)
unnamed: Rlim1.2, U1.2 (ILIM)

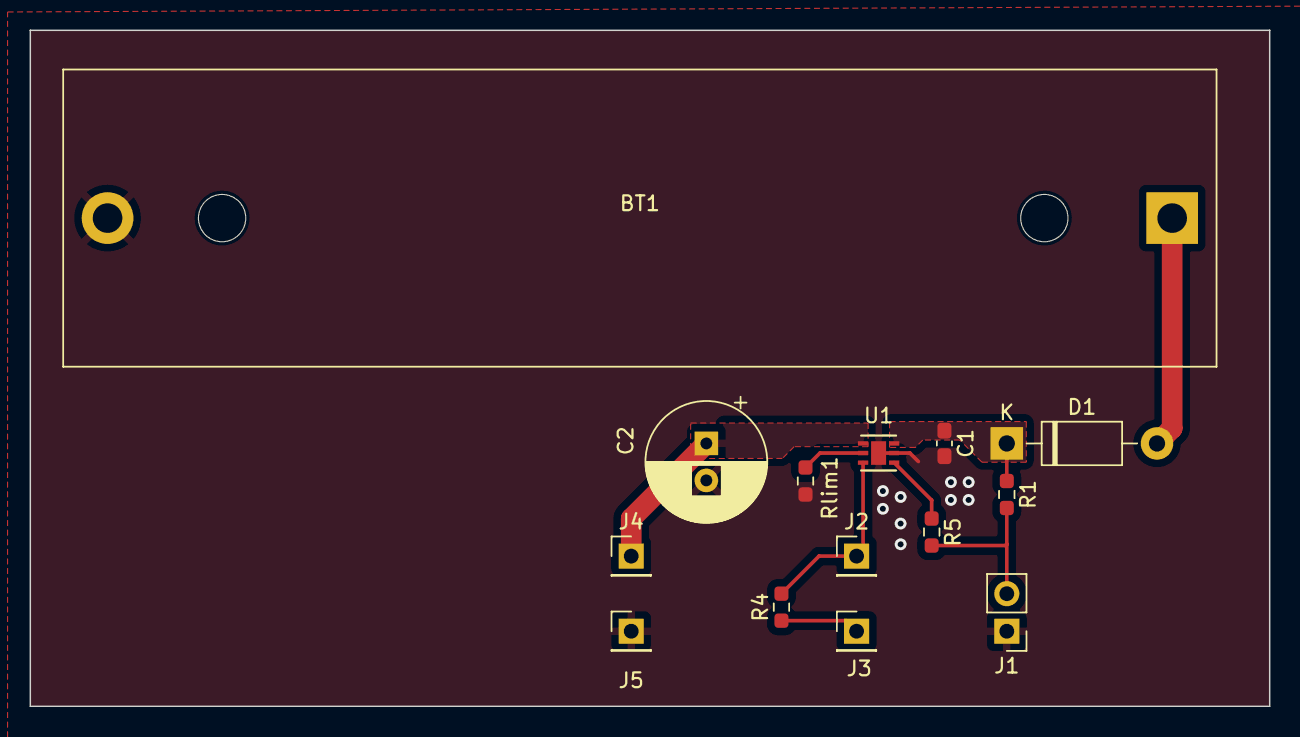
[picture p34: board test.kicad_pcb from above]

Board: 2 copper layers, 83.8 x 45.7 mm, 14 parts (0 on the bottom side), 9 nets.
