light655/EENight_light_dance/inverter_v1/EL_oscillator/EL_oscillator.kicad_pcb

## KiCad design inverter_v1/EL_oscillator/EL_oscillator.kicad_pcb (2024-02-23)

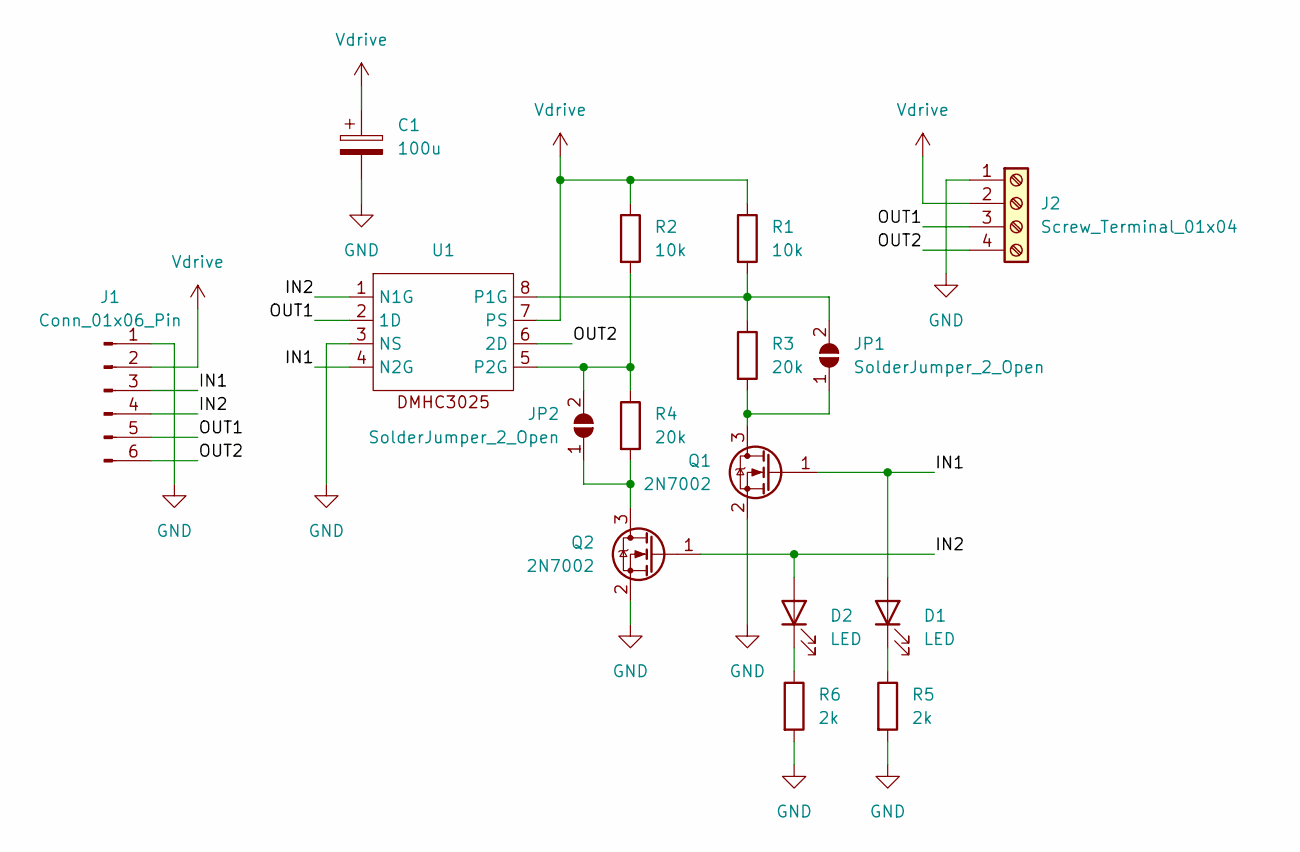
[picture p35: schematic EL_oscillator.kicad_sch]

Parts:
C1: 100u; CP_Radial_D5.0mm_P2.00mm
D1, D2: LED; LED_0603_1608Metric_Pad1.05x0.95mm_HandSolder; LCSC C2286
J1: Conn_01x06_Pin; PinHeader_1x06_P2.54mm_Vertical
J2: Screw_Terminal_01x04; TerminalBlock_bornier-4_P5.08mm
JP1, JP2: SolderJumper_2_Open; SolderJumper-2_P1.3mm_Open_RoundedPad1.0x1.5mm
Q1, Q2: 2N7002; SOT-23; LCSC C8545
R1, R2: 10k; R_0603_1608Metric_Pad0.98x0.95mm_HandSolder; LCSC C25804
R3, R4: 20k; R_0603_1608Metric_Pad0.98x0.95mm_HandSolder; LCSC C4184
R5, R6: 2k; R_0603_1608Metric_Pad0.98x0.95mm_HandSolder; LCSC C22975
U1: SO-8_3.9x4.9mm_P1.27mm; LCSC C156387

Connections:
/IN1: D1.2 (A), J1.3, Q1.1 (G), U1.4 (N2G)
/IN2: D2.2 (A), J1.4, Q2.1 (G), U1.1 (N1G)
/OUT1: J1.5, J2.3, U1.2 (1D)
/OUT2: J1.6, J2.4, U1.6 (2D)
GND: C1.2, J1.1, J2.1, Q1.2 (S), Q2.2 (S), R5.2, R6.2, U1.3 (NS)
unnamed: D1.1 (K), R5.1
unnamed: D2.1 (K), R6.1
unnamed: JP1.1 (A), Q1.3 (D), R3.2
unnamed: JP1.2 (B), R1.2, R3.1, U1.8 (P1G)
unnamed: JP2.1 (A), Q2.3 (D), R4.2
unnamed: JP2.2 (B), R2.2, R4.1, U1.5 (P2G)
Vdrive: C1.1, J1.2, J2.2, R1.1, R2.1, U1.7 (PS)

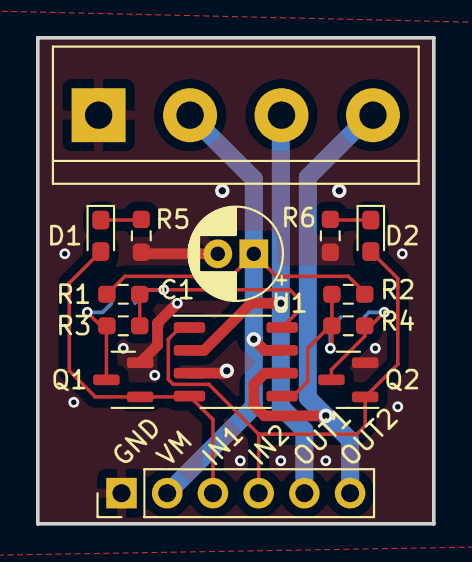
[picture p36: board EL_oscillator.kicad_pcb from above]

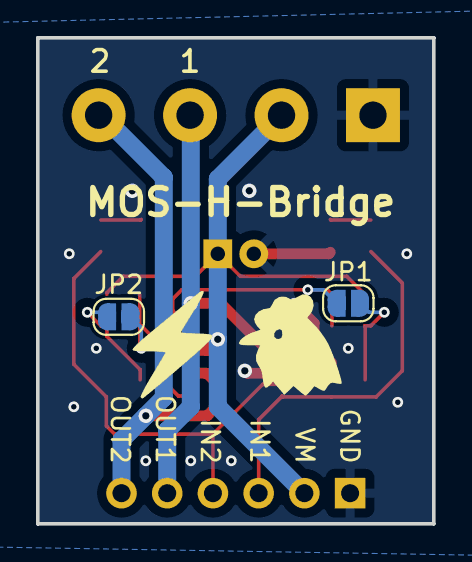
[picture p37: board EL_oscillator.kicad_pcb from below]

Board: 2 copper layers, 22.0 x 27.0 mm, 16 parts (2 on the bottom side), 12 nets.
