light655/EENight_light_dance/AC_switch/AC_triac_switch/AC_triac_switch.kicad_sch

## KiCad design AC_switch/AC_triac_switch/AC_triac_switch.kicad_sch (2024-02-27)

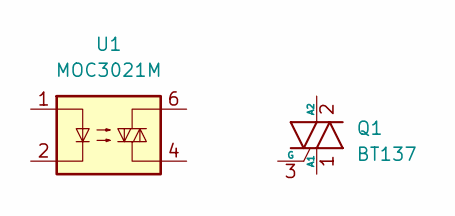
[picture p38: schematic AC_triac_switch.kicad_sch]

Parts:
Q1: BT137; TO-252-2
U1: MOC3021M
