light655/EENight_light_dance/HV_H_bridge/HV_H_bridge/HV_H_bridge.kicad_sch

## KiCad design HV_H_bridge/HV_H_bridge/HV_H_bridge.kicad_sch (2024-03-02)

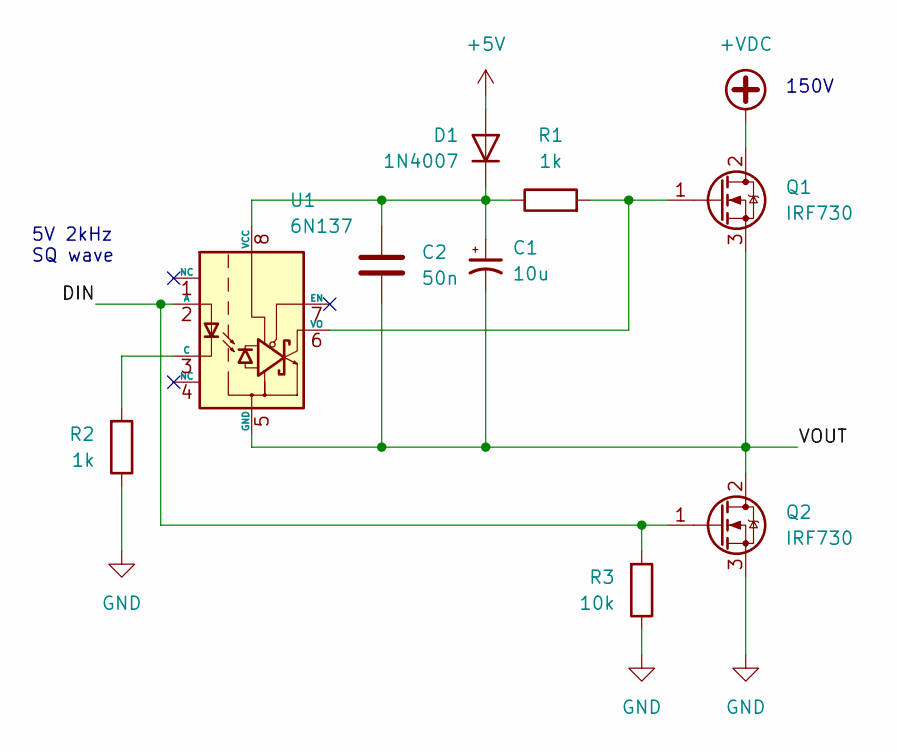
[picture p39: schematic HV_H_bridge.kicad_sch]

Parts:
C1: 10u
C2: 50n
D1: 1N4007; D_DO-41_SOD81_P10.16mm_Horizontal
Q1, Q2: IRF730; TO-220-3_Vertical
R1, R2: 1k
R3: 10k
U1: 6N137; DIP-8_W7.62mm

Connections:
+5V: D1.2 (A)
+VDC: Q1.2 (D)
DIN: Q2.1 (G), R3.2, U1.2 (A)
GND: Q2.3 (S), R2.1, R3.1
unnamed: C1.1, C2.1, D1.1 (K), R1.1, U1.8 (VCC)
unnamed: Q1.1 (G), R1.2, U1.6 (VO)
unnamed: R2.2, U1.3 (C)
VOUT: C1.2, C2.2, Q1.3 (S), Q2.2 (D), U1.5 (GND)

Notes on the sheet:
150V
5V 2kHz SQ wave
