light655/EENight_light_dance/software/pindef.h

#ifndef PINDEF_H
#define PINDEF_H

#define LDO_EN0 1
#define LDO_EN1 3
#define LDO_EN2 5
#define LDO_EN3 7
#define PWM_PIN0 0
#define PWM_PIN1 2
#define PWM_PIN2 4
#define PWM_PIN3 6
#define SPI_CS0 10
#define SPI_CS1 11
#define SPI_CS2 12
#define SPI_CS3 13
#define SPI_CLK 18
#define SPI_TX 19
#define MUX_S0 20
#define MUX_S1 21
#define VC_SENSE 26
#define VL_SENSE 27
#define VBAT_SENSE 28
#define LED_R 8
#define LED_G 9
#define LED_PICO 25
#define T_SYNC 14

#endif
