light655/EENight_light_dance/software/setting3.h

const float current_low_threshold[4] = {0.03f, 0.03f, 0.03f, 0.03f};
const float control_gain[4] = {50.0f, 50.0f, 50.0f, 50.0f};
const float derivative_gain[4] = {1000.0f, 1000.0f, 1000.0f, 1000.0f};
const float	current_max[4] = { 0.45f , 0.35f , 0.45f , 0.25f };
