light655/EENight_light_dance/software/midi_array.h

const int32_t AD_t[1000] = {-1
};

const int32_t AD_s[1000] = {-1
};

const int32_t A_t[1000] = {
	22858112, 24761880, 24762872, 26666640, 30477152, 32380920, 32381912, 34285680, 40953332, 41904720, 
	41905712, 43809480, 43810472, 45714240, 53334272, 55238040, 55239032, 57142800, 57619984, 58095180, 
	58572364, 59047560, 59524744, 59999940, 60477124, 60952320, 60953312, 62857080, 62858072, 63333268, 
	65239020, 65476124, 68572352, 70476120, 70477112, 72380880, 72381872, 73333256, 73334248, 74285632, 
	74286624, 75238008, 76191384, 78095152, 78096144, 79999912, 83810424, 84166576, 84286616, 84642768, 
	84762808, 85118960, 85239000, 85595152, 85715192, 86071344, 86191384, 86547536, 86667576, 87023728, 
	87619960, 89047536, 89524720, 91428488, 91429480, 93333248, 93334240, 95238008, 95358048, 95476104, 
	95477096, 96190392, 98572336, 99047536, 100953288, 102857056, 102858048, 104761816, 108572328, 110476096, 
	110477088, 112380856, 119048512, 119999896, 120000888, 121904656, 121905648, 123809416, 131429448, 133333216, 
	133334208, 135237984, 135715168, 136190368, 136667552, 137142752, 137619936, 138095136, 138572320, 139047520, 
	139048512, 140952288, 140953280, 141428480, 143334240, 143571344, 146667568, 148571328, 148572320, 150476096, 
	150477088, 151428480, 151429472, 152380864, 152381856, 153333248, 154286624, 156190400, 156191392, 158095168, 
	165715200, 167618976, 167619968, 169523744, 169524736, 171428512, 171429504, 172380896, 172381888, 173333280, 
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
	126, 0, 126, 0, 126, 0, 126, 0, 126, 0, 
	126, 0, 126, 0, 126, 0, 126, 0, 126, 0, 
	126, 0, 126, 0, 126, 0, 126, 0, 126, 0, 
	126, 0, 126, 0, 126, 0, 126, 0, 126, 0, 
	126, 0, 126, 0, 126, 0, 126, 0, 126, 0, 
	126, 0, 126, 0, 126, 0, 126, 0, 126, 0, 
	126, 0, 126, 0, 126, 0, 126, 0, 126, 0, 
	126, 0, 126, 0, 126, 0, 126, 0, 126, 0, 
	126, 0, 126, 0, 126, 0, 126, 0, 126, 0, 
	126, 0, 126, 0, 126, 0, 126, 0, 126, 0, 
	126, 0, 126, 0, 126, 0, 126, 0, 126, 0, 
	126, 0, 126, 0, 126, 0, 126, 0, 126, 0, 
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
};

const int32_t DC_t[1000] = {-1
};

const int32_t DC_s[1000] = {-1
};
