light655/EENight_light_dance/(commit log)

2024-02-23 Added H-bridge.
    [EL_oscillator-B_Cu.gbl, EL_oscillator-B_Mask.gbs, EL_oscillator-B_Paste.gbp, EL_oscillator-B_Silkscreen.gbo, EL_oscillator-Edge_Cuts.gm1, EL_oscillator-F_Cu.gtl, EL_oscillator-F_Mask.gts, EL_oscillator-F_Paste.gtp]
2024-02-23 Added basic tsp25200 circuit
    [test.kicad_pcb, test.kicad_sch]
2024-02-23 Added BT137 symbol.
    [AC_triac_switch.kicad_pcb, AC_triac_switch.kicad_sch]
2024-02-27 Added MOC3021M to schematic.
    [AC_triac_switch.kicad_sch]
2024-03-01 New BMS schematic.
    [BMS_hardware.kicad_pcb, BMS_hardware.kicad_sch]
2024-03-02 Added MAX660 for voltage doubling.
    [BMS_hardware.kicad_sch, HV_H_bridge.kicad_pcb, HV_H_bridge.kicad_sch]
2024-03-04 Added basic pwm dc step down funtion for pico
2024-03-17 First schematic version.
    [ASP.kicad_sch, BMS.kicad_sch, BMS_hardware.kicad_pcb, BMS_hardware.kicad_sch, EENLD_main.kicad_pcb, EENLD_main.kicad_sch, ELDM.kicad_sch, bom.csv]
2024-03-20 Finished PCB layout v0.1.
    [ASP.kicad_sch, BMS.kicad_sch, EENLD_main.kicad_pcb, EENLD_main.kicad_sch, ELDM.kicad_sch, bom.csv, designators.csv, positions.csv]
2024-04-01 added midi2array
    [ASP.kicad_sch, BMS.kicad_sch, EENLD_main.kicad_pcb, EENLD_main.kicad_sch, ELDM.kicad_sch, bom.csv, designators.csv, positions.csv]
2024-04-12 Fixed command line argument in midi2array_mod
    [main.c]
2024-04-16 fix the blinking frame , change to 60Hz , manual added
2024-04-27 try to fix flase disable
    [core1.h]
2024-04-28 Changed LED pin.
2024-04-28 Fixed track issue.
2024-04-28 Tweaked Pico firmware
2024-04-28 fix sth fucked up
    [core1.h]
